swittlich/CcSoM/SoM/SOM.kicad_pcb

## KiCad design SoM/SOM.kicad_pcb (2026-09-17)

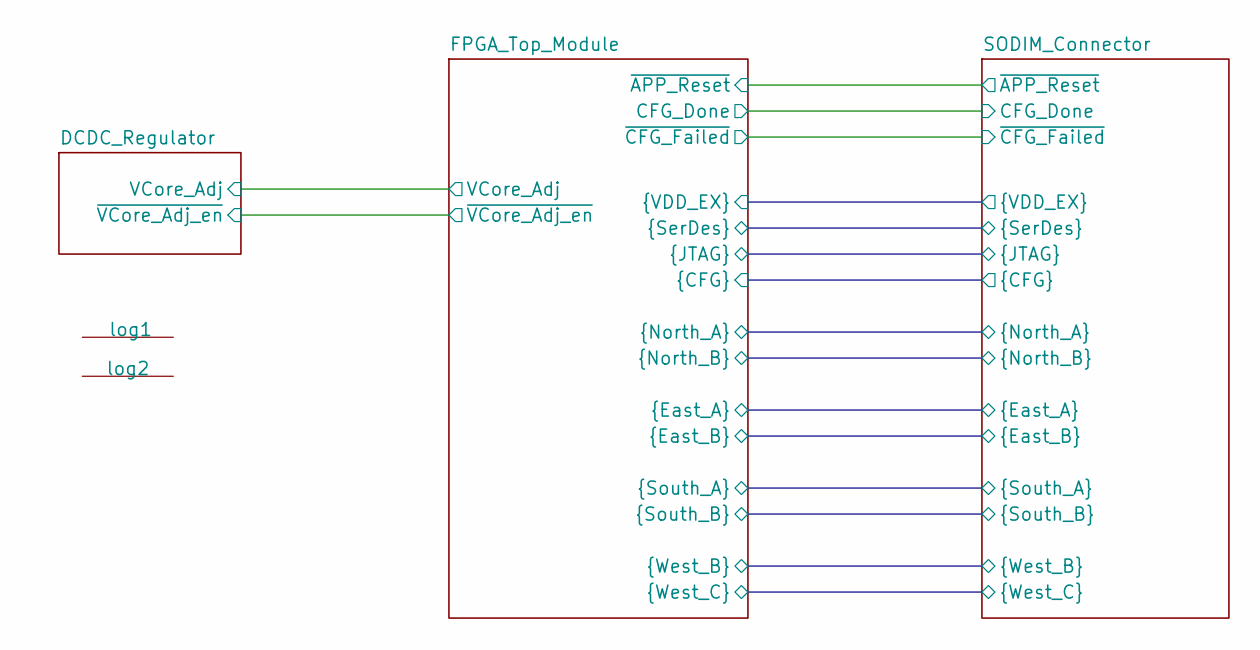
[picture p1: schematic SOM.kicad_sch, CCSoM]

Parts:
log1: PinguinLogo
log2: OpenHardwareLogo

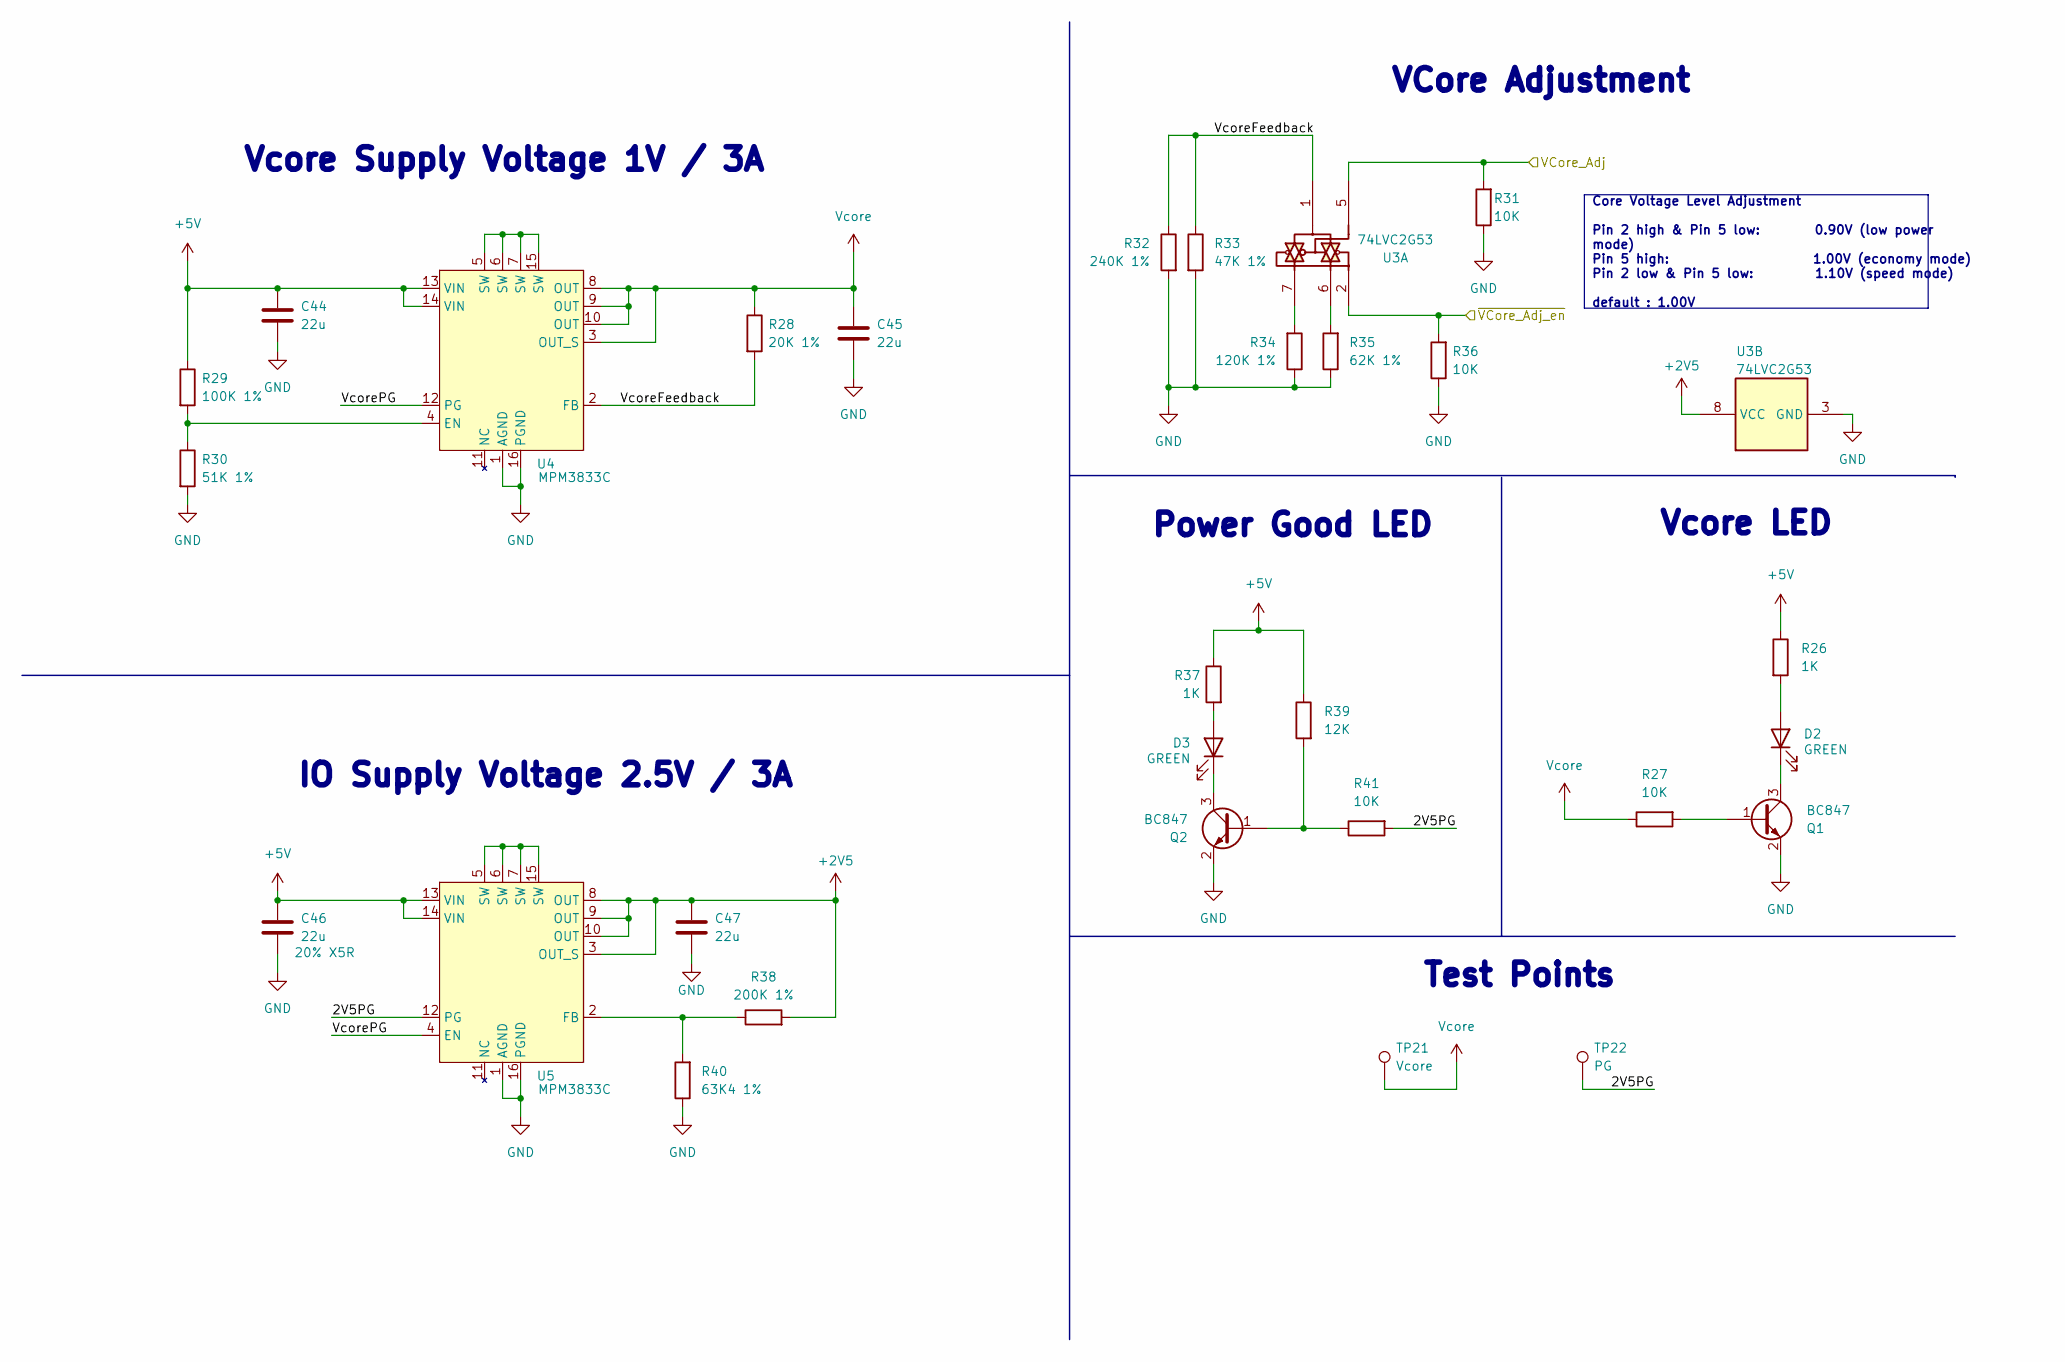
[picture p2: schematic DCDC.kicad_sch, CCSoM]

Parts:
C44, C45, C46, C47: 22u; C_0603_1608Metric; Mouser Part Number GRM188C61C226ME01W
D2, D3: GREEN; LED_0603_1608Metric; Mouser Part Number 150060VS75000
Q1, Q2: BC847; SOT-23; Mouser Part Number BC847C-C
R26, R37: 1K; R_0402_1005Metric; Mouser Part Number MCS04020C1001FE000
R27, R31, R36, R41: 10K; R_0402_1005Metric; Mouser Part Number MCS0402MC1002FE000
R28: 20K 1%; R_0402_1005Metric; Mouser Part Number CRCW040220K0FKED
R29: 100K 1%; R_0402_1005Metric; Mouser Part Number MCS04020C1003FE000
R30: 51K 1%; R_0402_1005Metric; Mouser Part Number CRCW040251K0FKEDC
R32: 240K 1%; R_0402_1005Metric; Mouser Part Number MCS04020C2403FE000
R33: 47K 1%; R_0402_1005Metric; Mouser Part Number CRCW040247K0FKED
R34: 120K 1%; R_0402_1005Metric; Mouser Part Number MCS04020C1203FE000
R35: 62K 1%; R_0402_1005Metric; Mouser Part Number CRCW040262K0FKED
R38: 200K 1%; R_0402_1005Metric; Mouser Part Number CRCW0402200KFKEDC
R39: 12K; R_0402_1005Metric; Mouser Part Number MCS04020C1202FE000
R40: 63K4 1%; R_0402_1005Metric; Mouser Part Number CRCW040263K4FKED
TP21: Vcore; TestPoint_Pad_D1.0mm
TP22: PG; TestPoint_Pad_D1.0mm
U3: 74LVC2G53; DCU8; Mouser Part Number SN74LVC2G53DCUR
U4, U5: MPM3833C; QFN18; Mouser Part Number MPM3833CGRH-Z

Connections:
+2V5: C47.1, R38.2, U3.8 (VCC), U5.3 (OUT_S), U5.8 (OUT), U5.9 (OUT), U5.10 (OUT), U5.20 (OUT); also elsewhere on the board
+5V: C44.1, C46.1, R26.1, R29.1, R37.1, R39.1, U4.13 (VIN), U4.14 (VIN), U5.13 (VIN), U5.14 (VIN); also elsewhere on the board
/DCDC_Regulator/2V5PG: R41.2, TP22.1 (1_1), U5.12 (PG)
/DCDC_Regulator/VcoreFeedback: R28.2, R32.1, R33.1, U3.1, U4.2 (FB)
/DCDC_Regulator/VcorePG: U4.12 (PG), U5.4 (EN)
/FPGA_Top_Module/VcAdj: R31.2, U3.5; also elsewhere on the board
/FPGA_Top_Module/~VcAen: R36.2, U3.2; also elsewhere on the board
GND: C44.2, C45.2, C46.2, C47.2, Q1.2 (E), Q2.2 (E), R30.2, R31.1, R32.2, R33.2, R34.1, R35.1, R36.1, R40.1, U3.3 (GND), U3.4 (GND), U4.1 (AGND), U4.16 (PGND), U5.1 (AGND), U5.16 (PGND); also elsewhere on the board
unnamed: D2.2 (A), R26.2
unnamed: D2.1 (K), Q1.3 (C)
unnamed: D3.2 (A), R37.2
unnamed: D3.1 (K), Q2.3 (C)
unnamed: Q1.1 (B), R27.2
unnamed: Q2.1 (B), R39.2, R41.1
unnamed: R34.2, U3.7
unnamed: R35.2, U3.6
unnamed: R29.2, R30.1, U4.4 (EN)
unnamed: U4.5 (SW), U4.6 (SW), U4.7 (SW), U4.15 (SW), U4.19 (SW)
unnamed: R38.1, R40.2, U5.2 (FB)
unnamed: U5.5 (SW), U5.6 (SW), U5.7 (SW), U5.15 (SW), U5.19 (SW)
Vcore: C45.1, R27.1, R28.1, TP21.1 (1_1), U4.3 (OUT_S), U4.8 (OUT), U4.9 (OUT), U4.10 (OUT), U4.20 (OUT); also elsewhere on the board

Notes on the sheet:
Power Good LED
Test Points
Vcore LED
Vcore Supply Voltage 1V / 3A
IO Supply Voltage 2.5V / 3A
VCore Adjustment
Core Voltage Level Adjustment Pin 2 high & Pin 5 low: 0.90V (low power mode) Pin 5 high: 1.00V (economy mode) Pin 2 low & Pin 5 low: 1.10V (speed mode) default : 1.00V

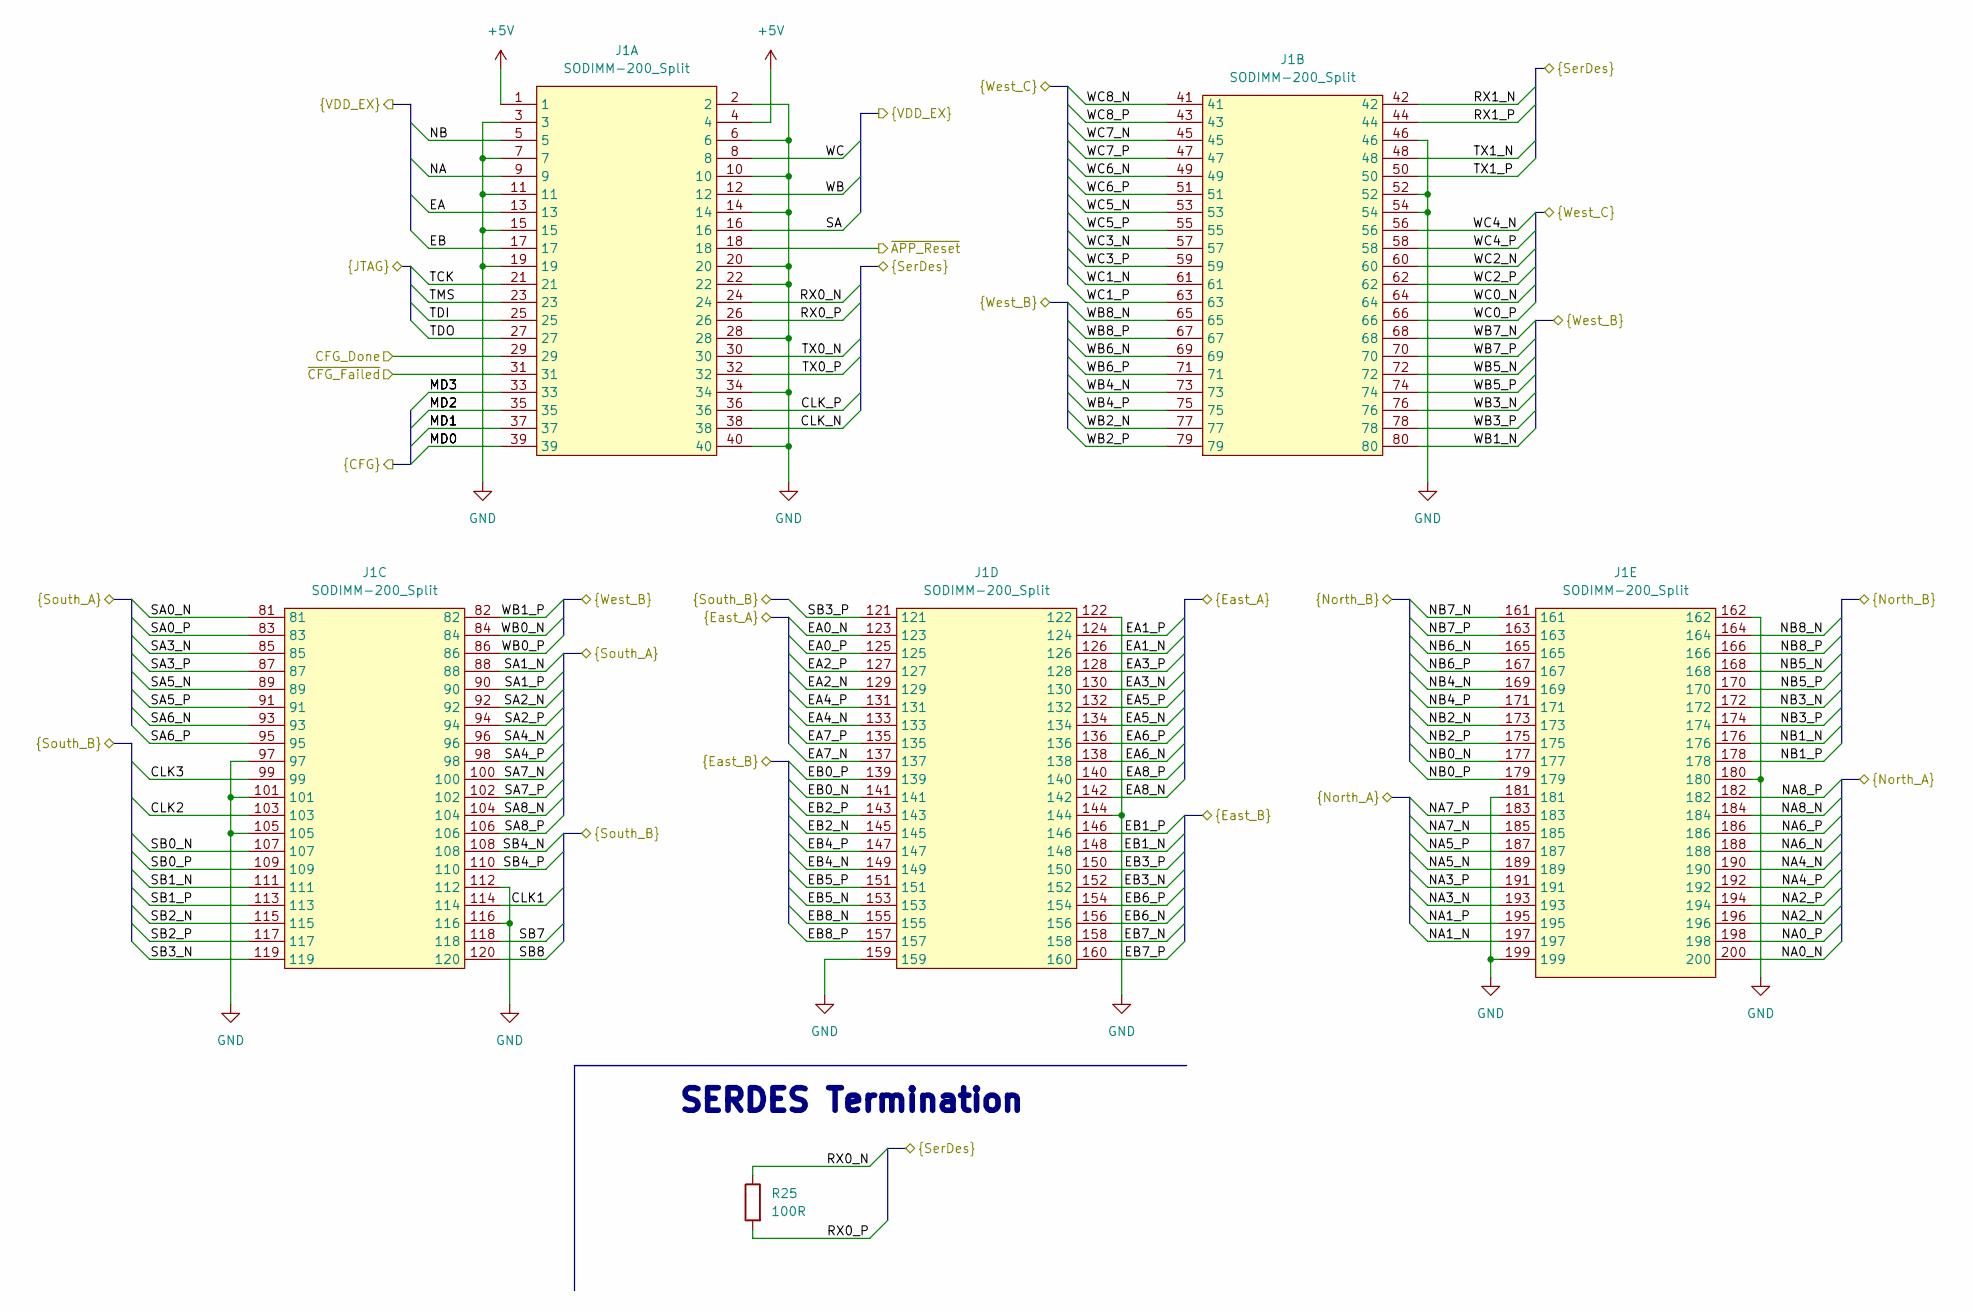
[picture p3: schematic SODIM.kicad_sch, CCSoM]

Parts:
J1: SODIMM-200_Split; SODIMM-200_2.5V_Card_edge
R25: 100R; R_0402_1005Metric; Mouser Part Number MCS04020C1000FE000

Connections:
+5V: J1.1, J1.4; also elsewhere on the board
/FPGA_Top_Module/CFG_Done: J1.29; also elsewhere on the board
/FPGA_Top_Module/CLK1: J1.114; also elsewhere on the board
/FPGA_Top_Module/CLK2: J1.103; also elsewhere on the board
/FPGA_Top_Module/CLK3: J1.99; also elsewhere on the board
/FPGA_Top_Module/CLK_N: J1.38; also elsewhere on the board
/FPGA_Top_Module/CLK_P: J1.36; also elsewhere on the board
/FPGA_Top_Module/EA: J1.13; also elsewhere on the board
/FPGA_Top_Module/EA0_N: J1.123; also elsewhere on the board
/FPGA_Top_Module/EA0_P: J1.125; also elsewhere on the board
/FPGA_Top_Module/EA1_N: J1.126; also elsewhere on the board
/FPGA_Top_Module/EA1_P: J1.124; also elsewhere on the board
/FPGA_Top_Module/EA2_N: J1.129; also elsewhere on the board
/FPGA_Top_Module/EA2_P: J1.127; also elsewhere on the board
/FPGA_Top_Module/EA3_N: J1.130; also elsewhere on the board
/FPGA_Top_Module/EA3_P: J1.128; also elsewhere on the board
/FPGA_Top_Module/EA4_N: J1.133; also elsewhere on the board
/FPGA_Top_Module/EA4_P: J1.131; also elsewhere on the board
/FPGA_Top_Module/EA5_N: J1.134; also elsewhere on the board
/FPGA_Top_Module/EA5_P: J1.132; also elsewhere on the board
/FPGA_Top_Module/EA6_N: J1.138; also elsewhere on the board
/FPGA_Top_Module/EA6_P: J1.136; also elsewhere on the board
/FPGA_Top_Module/EA7_N: J1.137; also elsewhere on the board
/FPGA_Top_Module/EA7_P: J1.135; also elsewhere on the board
/FPGA_Top_Module/EA8_N: J1.142; also elsewhere on the board
/FPGA_Top_Module/EA8_P: J1.140; also elsewhere on the board
/FPGA_Top_Module/EB: J1.17; also elsewhere on the board
/FPGA_Top_Module/EB0_N: J1.141; also elsewhere on the board
/FPGA_Top_Module/EB0_P: J1.139; also elsewhere on the board
/FPGA_Top_Module/EB1_N: J1.148; also elsewhere on the board
/FPGA_Top_Module/EB1_P: J1.146; also elsewhere on the board
/FPGA_Top_Module/EB2_N: J1.145; also elsewhere on the board
/FPGA_Top_Module/EB2_P: J1.143; also elsewhere on the board
/FPGA_Top_Module/EB3_N: J1.152; also elsewhere on the board
/FPGA_Top_Module/EB3_P: J1.150; also elsewhere on the board
/FPGA_Top_Module/EB4_N: J1.149; also elsewhere on the board
/FPGA_Top_Module/EB4_P: J1.147; also elsewhere on the board
/FPGA_Top_Module/EB5_N: J1.153; also elsewhere on the board
/FPGA_Top_Module/EB5_P: J1.151; also elsewhere on the board
/FPGA_Top_Module/EB6_N: J1.156; also elsewhere on the board
/FPGA_Top_Module/EB6_P: J1.154; also elsewhere on the board
/FPGA_Top_Module/EB7_N: J1.158; also elsewhere on the board
/FPGA_Top_Module/EB7_P: J1.160; also elsewhere on the board
/FPGA_Top_Module/EB8_N: J1.155; also elsewhere on the board
/FPGA_Top_Module/EB8_P: J1.157; also elsewhere on the board
/FPGA_Top_Module/MD0: J1.39; also elsewhere on the board
/FPGA_Top_Module/MD1: J1.37; also elsewhere on the board
/FPGA_Top_Module/MD2: J1.35; also elsewhere on the board
/FPGA_Top_Module/MD3: J1.33; also elsewhere on the board
/FPGA_Top_Module/NA: J1.9; also elsewhere on the board
/FPGA_Top_Module/NA0_N: J1.200; also elsewhere on the board
/FPGA_Top_Module/NA0_P: J1.198; also elsewhere on the board
/FPGA_Top_Module/NA1_N: J1.197; also elsewhere on the board
/FPGA_Top_Module/NA1_P: J1.195; also elsewhere on the board
/FPGA_Top_Module/NA2_N: J1.196; also elsewhere on the board
/FPGA_Top_Module/NA2_P: J1.194; also elsewhere on the board
/FPGA_Top_Module/NA3_N: J1.193; also elsewhere on the board
/FPGA_Top_Module/NA3_P: J1.191; also elsewhere on the board
/FPGA_Top_Module/NA4_N: J1.190; also elsewhere on the board
/FPGA_Top_Module/NA4_P: J1.192; also elsewhere on the board
/FPGA_Top_Module/NA5_N: J1.189; also elsewhere on the board
/FPGA_Top_Module/NA5_P: J1.187; also elsewhere on the board
/FPGA_Top_Module/NA6_N: J1.188; also elsewhere on the board
/FPGA_Top_Module/NA6_P: J1.186; also elsewhere on the board
/FPGA_Top_Module/NA7_N: J1.185; also elsewhere on the board
/FPGA_Top_Module/NA7_P: J1.183; also elsewhere on the board
/FPGA_Top_Module/NA8_N: J1.184; also elsewhere on the board
/FPGA_Top_Module/NA8_P: J1.182; also elsewhere on the board
/FPGA_Top_Module/NB: J1.5; also elsewhere on the board
/FPGA_Top_Module/NB0_N: J1.177; also elsewhere on the board
/FPGA_Top_Module/NB0_P: J1.179; also elsewhere on the board
/FPGA_Top_Module/NB1_N: J1.176; also elsewhere on the board
/FPGA_Top_Module/NB1_P: J1.178; also elsewhere on the board
/FPGA_Top_Module/NB2_N: J1.173; also elsewhere on the board
/FPGA_Top_Module/NB2_P: J1.175; also elsewhere on the board
/FPGA_Top_Module/NB3_N: J1.172; also elsewhere on the board
/FPGA_Top_Module/NB3_P: J1.174; also elsewhere on the board
/FPGA_Top_Module/NB4_N: J1.169; also elsewhere on the board
/FPGA_Top_Module/NB4_P: J1.171; also elsewhere on the board
/FPGA_Top_Module/NB5_N: J1.168; also elsewhere on the board
/FPGA_Top_Module/NB5_P: J1.170; also elsewhere on the board
/FPGA_Top_Module/NB6_N: J1.165; also elsewhere on the board
/FPGA_Top_Module/NB6_P: J1.167; also elsewhere on the board
/FPGA_Top_Module/NB7_N: J1.161; also elsewhere on the board
/FPGA_Top_Module/NB7_P: J1.163; also elsewhere on the board
/FPGA_Top_Module/NB8_N: J1.164; also elsewhere on the board
/FPGA_Top_Module/NB8_P: J1.166; also elsewhere on the board
/FPGA_Top_Module/RX0_N: J1.24, R25.1; also elsewhere on the board
/FPGA_Top_Module/RX0_P: J1.26, R25.2; also elsewhere on the board
/FPGA_Top_Module/RX1_N: J1.42; also elsewhere on the board
/FPGA_Top_Module/RX1_P: J1.44; also elsewhere on the board
/FPGA_Top_Module/SA: J1.16; also elsewhere on the board
/FPGA_Top_Module/SA0_N: J1.81; also elsewhere on the board
/FPGA_Top_Module/SA0_P: J1.83; also elsewhere on the board
/FPGA_Top_Module/SA1_N: J1.88; also elsewhere on the board
/FPGA_Top_Module/SA1_P: J1.90; also elsewhere on the board
/FPGA_Top_Module/SA2_N: J1.92; also elsewhere on the board
/FPGA_Top_Module/SA2_P: J1.94; also elsewhere on the board
/FPGA_Top_Module/SA3_N: J1.85; also elsewhere on the board
/FPGA_Top_Module/SA3_P: J1.87; also elsewhere on the board
/FPGA_Top_Module/SA4_N: J1.96; also elsewhere on the board
/FPGA_Top_Module/SA4_P: J1.98; also elsewhere on the board
/FPGA_Top_Module/SA5_N: J1.89; also elsewhere on the board
/FPGA_Top_Module/SA5_P: J1.91; also elsewhere on the board
/FPGA_Top_Module/SA6_N: J1.93; also elsewhere on the board
/FPGA_Top_Module/SA6_P: J1.95; also elsewhere on the board
/FPGA_Top_Module/SA7_N: J1.100; also elsewhere on the board
/FPGA_Top_Module/SA7_P: J1.102; also elsewhere on the board
/FPGA_Top_Module/SA8_N: J1.104; also elsewhere on the board
/FPGA_Top_Module/SA8_P: J1.106; also elsewhere on the board
/FPGA_Top_Module/SB0_N: J1.107; also elsewhere on the board
/FPGA_Top_Module/SB0_P: J1.109; also elsewhere on the board
/FPGA_Top_Module/SB1_N: J1.111; also elsewhere on the board
/FPGA_Top_Module/SB1_P: J1.113; also elsewhere on the board
/FPGA_Top_Module/SB2_N: J1.115; also elsewhere on the board
/FPGA_Top_Module/SB2_P: J1.117; also elsewhere on the board
/FPGA_Top_Module/SB3_N: J1.119; also elsewhere on the board
/FPGA_Top_Module/SB3_P: J1.121; also elsewhere on the board
/FPGA_Top_Module/SB4_N: J1.108; also elsewhere on the board
/FPGA_Top_Module/SB4_P: J1.110; also elsewhere on the board
/FPGA_Top_Module/SB7: J1.118; also elsewhere on the board
/FPGA_Top_Module/SB8: J1.120; also elsewhere on the board
/FPGA_Top_Module/TCK: J1.21; also elsewhere on the board
/FPGA_Top_Module/TDI: J1.25; also elsewhere on the board
/FPGA_Top_Module/TDO: J1.27; also elsewhere on the board
/FPGA_Top_Module/TMS: J1.23; also elsewhere on the board
/FPGA_Top_Module/TX0_N: J1.30; also elsewhere on the board
/FPGA_Top_Module/TX0_P: J1.32; also elsewhere on the board
/FPGA_Top_Module/TX1_N: J1.48; also elsewhere on the board
/FPGA_Top_Module/TX1_P: J1.50; also elsewhere on the board
/FPGA_Top_Module/WB: J1.12; also elsewhere on the board
/FPGA_Top_Module/WB0_N: J1.84; also elsewhere on the board
/FPGA_Top_Module/WB0_P: J1.86; also elsewhere on the board
/FPGA_Top_Module/WB1_N: J1.80; also elsewhere on the board
/FPGA_Top_Module/WB1_P: J1.82; also elsewhere on the board
/FPGA_Top_Module/WB2_N: J1.77; also elsewhere on the board
/FPGA_Top_Module/WB2_P: J1.79; also elsewhere on the board
/FPGA_Top_Module/WB3_N: J1.76; also elsewhere on the board
/FPGA_Top_Module/WB3_P: J1.78; also elsewhere on the board
/FPGA_Top_Module/WB4_N: J1.73; also elsewhere on the board
/FPGA_Top_Module/WB4_P: J1.75; also elsewhere on the board
/FPGA_Top_Module/WB5_N: J1.72; also elsewhere on the board
/FPGA_Top_Module/WB5_P: J1.74; also elsewhere on the board
/FPGA_Top_Module/WB6_N: J1.69; also elsewhere on the board
/FPGA_Top_Module/WB6_P: J1.71; also elsewhere on the board
/FPGA_Top_Module/WB7_N: J1.68; also elsewhere on the board
/FPGA_Top_Module/WB7_P: J1.70; also elsewhere on the board
/FPGA_Top_Module/WB8_N: J1.65; also elsewhere on the board
/FPGA_Top_Module/WB8_P: J1.67; also elsewhere on the board
/FPGA_Top_Module/WC: J1.8; also elsewhere on the board
/FPGA_Top_Module/WC0_N: J1.64; also elsewhere on the board
/FPGA_Top_Module/WC0_P: J1.66; also elsewhere on the board
/FPGA_Top_Module/WC1_N: J1.61; also elsewhere on the board
/FPGA_Top_Module/WC1_P: J1.63; also elsewhere on the board
/FPGA_Top_Module/WC2_N: J1.60; also elsewhere on the board
/FPGA_Top_Module/WC2_P: J1.62; also elsewhere on the board
/FPGA_Top_Module/WC3_N: J1.57; also elsewhere on the board
/FPGA_Top_Module/WC3_P: J1.59; also elsewhere on the board
/FPGA_Top_Module/WC4_N: J1.56; also elsewhere on the board
/FPGA_Top_Module/WC4_P: J1.58; also elsewhere on the board
/FPGA_Top_Module/WC5_N: J1.53; also elsewhere on the board
/FPGA_Top_Module/WC5_P: J1.55; also elsewhere on the board
/FPGA_Top_Module/WC6_N: J1.49; also elsewhere on the board
/FPGA_Top_Module/WC6_P: J1.51; also elsewhere on the board
/FPGA_Top_Module/WC7_N: J1.45; also elsewhere on the board
/FPGA_Top_Module/WC7_P: J1.47; also elsewhere on the board
/FPGA_Top_Module/WC8_N: J1.41; also elsewhere on the board
/FPGA_Top_Module/WC8_P: J1.43; also elsewhere on the board
/FPGA_Top_Module/~CFG_Failed: J1.31; also elsewhere on the board
/FPGA_Top_Module/~Rst: J1.18; also elsewhere on the board
GND: J1.2, J1.3, J1.6, J1.7, J1.10, J1.11, J1.14, J1.15, J1.19, J1.20, J1.22, J1.28, J1.34, J1.40, J1.46, J1.52, J1.54, J1.97, J1.101, J1.105, J1.112, J1.116, J1.122, J1.144, J1.159, J1.162, J1.180, J1.181, J1.199; also elsewhere on the board

Notes on the sheet:
SERDES Termination

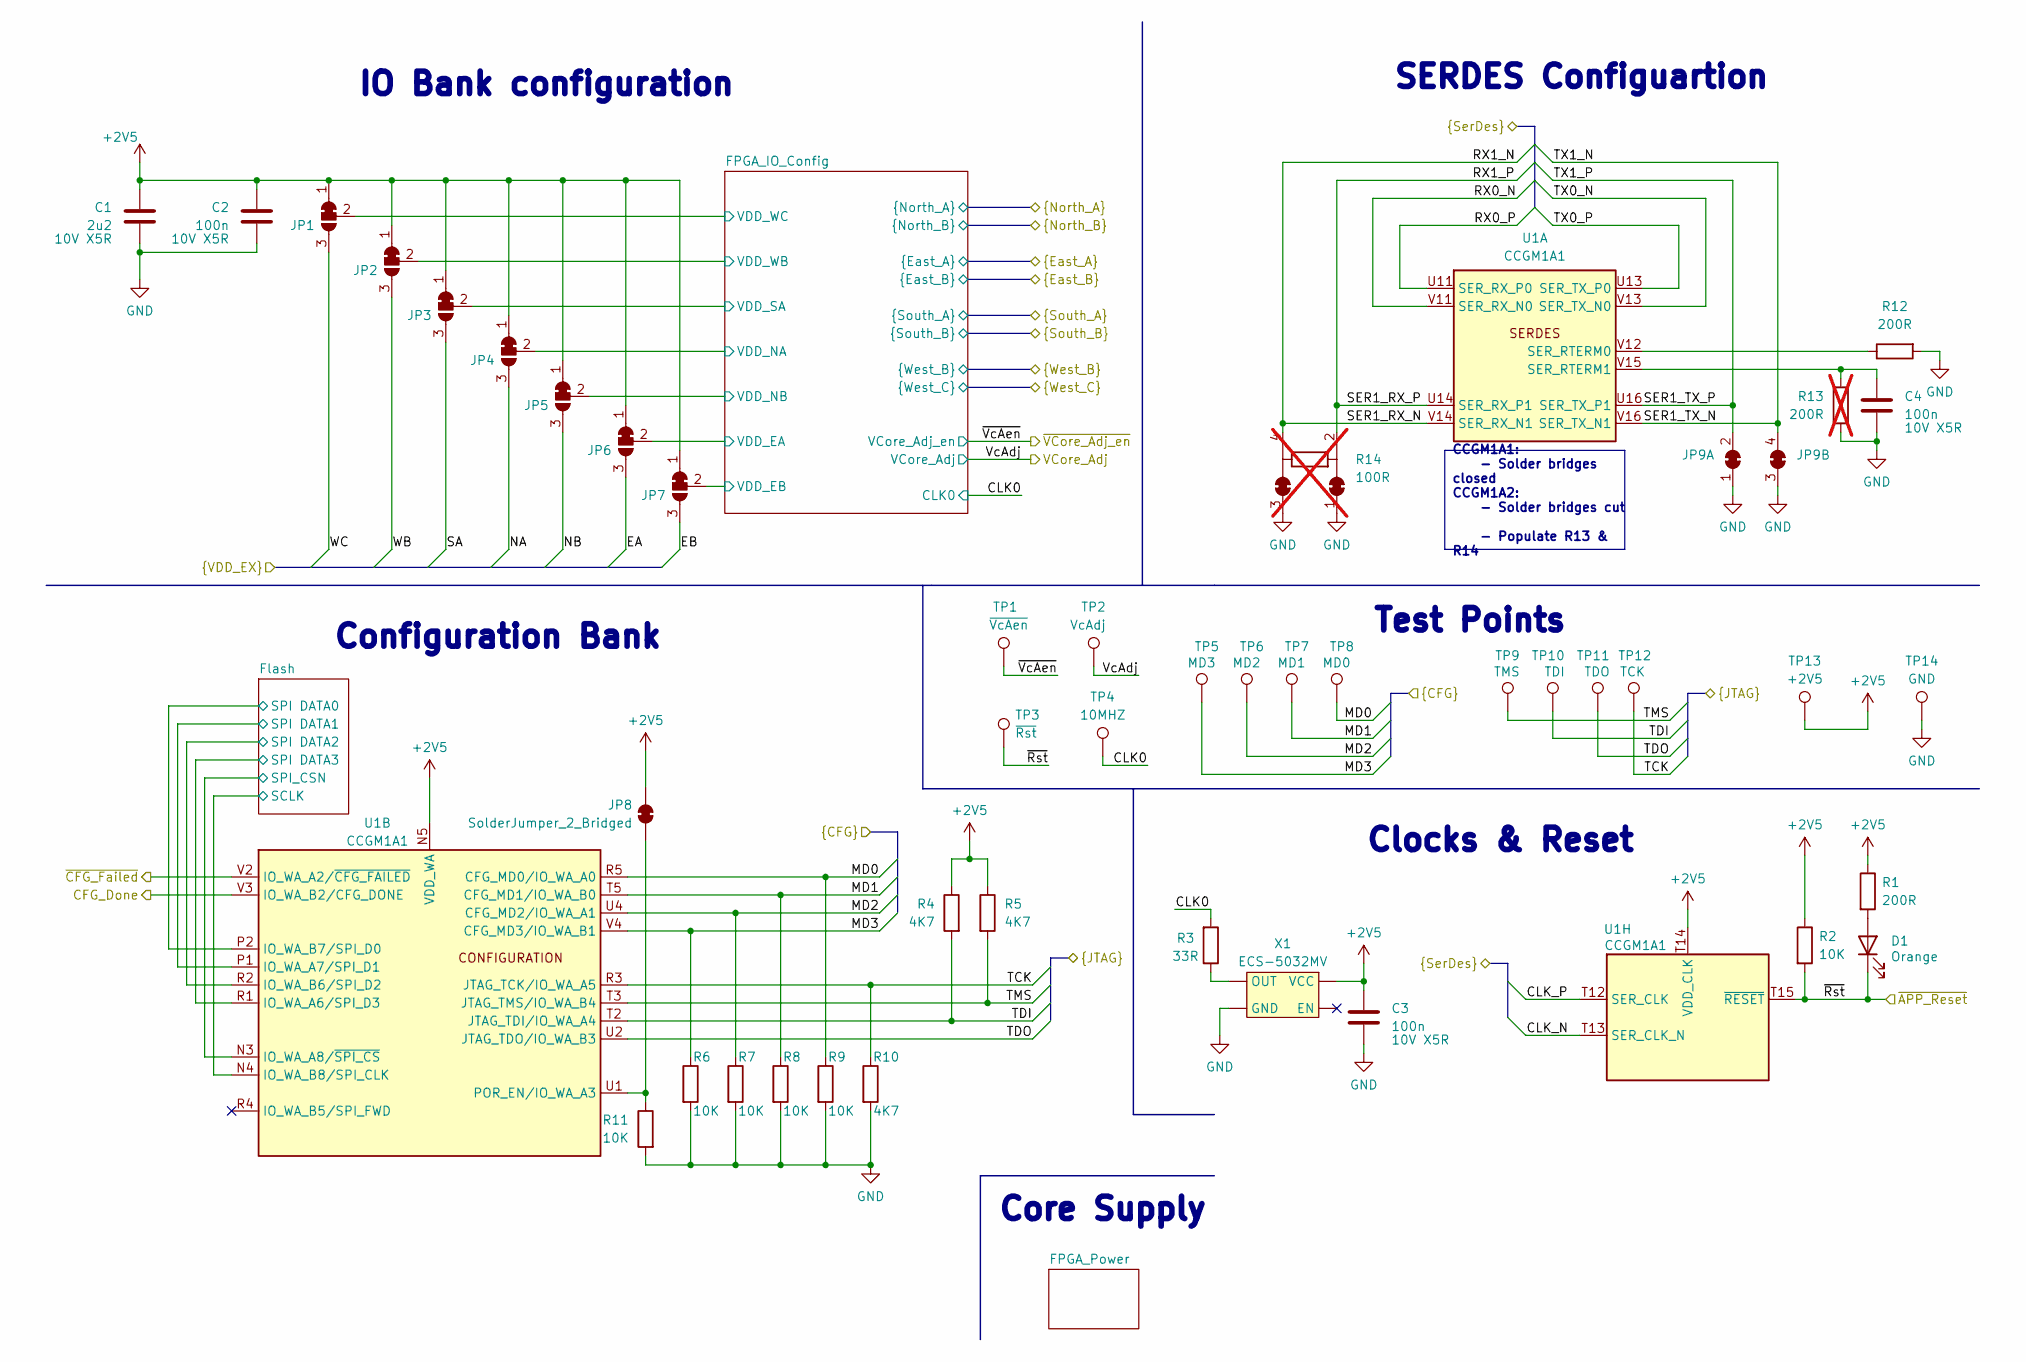
[picture p4: schematic FPGA_TOP.kicad_sch, CCSoM]

Parts:
C1: 2u2; C_0402_1005Metric; Voltage/Precision 10V X5R; Mouser Part Number GRM155Z71A225KE44D
C2, C3, C4: 100n; C_0402_1005Metric; Voltage/Precision 10V X5R; Mouser Part Number GRM155R71C104KA88J
D1: Orange; LED_0603_1608Metric; Mouser Part Number APT1608SECK-AMT
JP1, JP2, JP3, JP4, JP5, JP6, JP7: SolderJumper_3_Bridged12; SolderBridge3Pin
JP8: SolderJumper_2_Bridged; Solderbridge_closed
JP9: Diff_pair_solderbridge_closed
R1, R12: 200R; R_0402_1005Metric; Mouser Part Number MCS04020C2000FE000
R2, R6, R7, R8, R9, R11: 10K; R_0402_1005Metric; Mouser Part Number MCS0402MC1002FE000
R3: 33R; R_0402_1005Metric; Mouser Part Number MCS04020C3309FE000
R4, R5, R10: 4K7; R_0402_1005Metric; Mouser Part Number CRCW04024K70FKED
R13: 200R; R_0402_1005Metric; Mouser Part Number 71-CRCW0201-200; not fitted
R14: 100R; Diff_pair_solderbridge_closed; not fitted
TP1: ~{VcAen}; TestPoint_Pad_D1.0mm
TP2: VcAdj; TestPoint_Pad_D1.0mm
TP3: ~{Rst}; TestPoint_Pad_D1.0mm
TP4: 10MHZ; TestPoint_Pad_D1.0mm
TP5: MD3; TestPoint_Pad_D1.0mm
TP6: MD2; TestPoint_Pad_D1.0mm
TP7: MD1; TestPoint_Pad_D1.0mm
TP8: MD0; TestPoint_Pad_D1.0mm
TP9: TMS; TestPoint_Pad_D1.0mm
TP10: TDI; TestPoint_Pad_D1.0mm
TP11: TDO; TestPoint_Pad_D1.0mm
TP12: TCK; TestPoint_Pad_D1.0mm
TP13: +2V5; TestPoint_Pad_D1.0mm
TP14: GND; TestPoint_Pad_D1.0mm
U1: CCGM1A1; BGA-324_15x15mm_Layout18x18_P0.8mm; Mouser Part Number CCGM1A1-BGA324
X1: ECS-5032MV; 5x3.2_Oscillator; Mouser Part Number ECS-5032MV-100-BN-TR

Connections:
+2V5: C1.1, C2.1, C3.1, JP1.1 (A), JP2.1 (A), JP3.1 (A), JP4.1 (A), JP5.1 (A), JP6.1 (A), JP7.1 (A), JP8.2 (B), R1.1, R2.1, R4.1, R5.1, TP13.1 (1_1), U1.N5 (VDD_WA), U1.P3 (VDD_WA), U1.P5 (VDD_WA), U1.T1 (VDD_WA), U1.T14 (VDD_CLK), U1.U3 (VDD_WA), X1.4 (VCC); also elsewhere on the board
/FPGA_Top_Module/CFG_Done: U1.V3 (IO_WA_B2/CFG_DONE); also elsewhere on the board
/FPGA_Top_Module/CLK0: R3.2, TP4.1 (1_1); also elsewhere on the board
/FPGA_Top_Module/CLK_N: U1.T13 (SER_CLK_N); also elsewhere on the board
/FPGA_Top_Module/CLK_P: U1.T12 (SER_CLK); also elsewhere on the board
/FPGA_Top_Module/EA: JP6.3 (B); also elsewhere on the board
/FPGA_Top_Module/EB: JP7.3 (B); also elsewhere on the board
/FPGA_Top_Module/FPGA_IO_Config/VDD_EA: JP6.2 (C); also elsewhere on the board
/FPGA_Top_Module/FPGA_IO_Config/VDD_EB: JP7.2 (C); also elsewhere on the board
/FPGA_Top_Module/FPGA_IO_Config/VDD_NA: JP4.2 (C); also elsewhere on the board
/FPGA_Top_Module/FPGA_IO_Config/VDD_NB: JP5.2 (C); also elsewhere on the board
/FPGA_Top_Module/FPGA_IO_Config/VDD_SA: JP3.2 (C); also elsewhere on the board
/FPGA_Top_Module/FPGA_IO_Config/VDD_WB: JP2.2 (C); also elsewhere on the board
/FPGA_Top_Module/FPGA_IO_Config/VDD_WC: JP1.2 (C); also elsewhere on the board
/FPGA_Top_Module/Flash/SCLK: U1.N4 (IO_WA_B8/SPI_CLK); also elsewhere on the board
/FPGA_Top_Module/Flash/SPI DATA0: U1.P2 (IO_WA_B7/SPI_D0); also elsewhere on the board
/FPGA_Top_Module/Flash/SPI DATA1: U1.P1 (IO_WA_A7/SPI_D1); also elsewhere on the board
/FPGA_Top_Module/Flash/SPI DATA2: U1.R2 (IO_WA_B6/SPI_D2); also elsewhere on the board
/FPGA_Top_Module/Flash/SPI DATA3: U1.R1 (IO_WA_A6/SPI_D3); also elsewhere on the board
/FPGA_Top_Module/Flash/SPI_CSN: U1.N3 (IO_WA_A8/~SPI_CS); also elsewhere on the board
/FPGA_Top_Module/MD0: R9.1, TP8.1 (1_1), U1.R5 (CFG_MD0/IO_WA_A0); also elsewhere on the board
/FPGA_Top_Module/MD1: R8.1, TP7.1 (1_1), U1.T5 (CFG_MD1/IO_WA_B0); also elsewhere on the board
/FPGA_Top_Module/MD2: R7.1, TP6.1 (1_1), U1.U4 (CFG_MD2/IO_WA_A1); also elsewhere on the board
/FPGA_Top_Module/MD3: R6.1, TP5.1 (1_1), U1.V4 (CFG_MD3/IO_WA_B1); also elsewhere on the board
/FPGA_Top_Module/NA: JP4.3 (B); also elsewhere on the board
/FPGA_Top_Module/NB: JP5.3 (B); also elsewhere on the board
/FPGA_Top_Module/RX0_N: U1.V11 (SER_RX_N0); also elsewhere on the board
/FPGA_Top_Module/RX0_P: U1.U11 (SER_RX_P0); also elsewhere on the board
/FPGA_Top_Module/RX1_N: R14.4, U1.V14 (SER_RX_N1); also elsewhere on the board
/FPGA_Top_Module/RX1_P: R14.2, U1.U14 (SER_RX_P1); also elsewhere on the board
/FPGA_Top_Module/SA: JP3.3 (B); also elsewhere on the board
/FPGA_Top_Module/TCK: R10.1, TP12.1 (1_1), U1.R3 (JTAG_TCK/IO_WA_A5); also elsewhere on the board
/FPGA_Top_Module/TDI: R4.2, TP10.1 (1_1), U1.T2 (JTAG_TDI/IO_WA_A4); also elsewhere on the board
/FPGA_Top_Module/TDO: TP11.1 (1_1), U1.U2 (JTAG_TDO/IO_WA_B3); also elsewhere on the board
/FPGA_Top_Module/TMS: R5.2, TP9.1 (1_1), U1.T3 (JTAG_TMS/IO_WA_B4); also elsewhere on the board
/FPGA_Top_Module/TX0_N: U1.V13 (SER_TX_N0); also elsewhere on the board
/FPGA_Top_Module/TX0_P: U1.U13 (SER_TX_P0); also elsewhere on the board
/FPGA_Top_Module/TX1_N: JP9.4 (B), U1.V16 (SER_TX_N1); also elsewhere on the board
/FPGA_Top_Module/TX1_P: JP9.2 (B), U1.U16 (SER_TX_P1); also elsewhere on the board
/FPGA_Top_Module/VcAdj: TP2.1 (1_1); also elsewhere on the board
/FPGA_Top_Module/WB: JP2.3 (B); also elsewhere on the board
/FPGA_Top_Module/WC: JP1.3 (B); also elsewhere on the board
/FPGA_Top_Module/~CFG_Failed: U1.V2 (IO_WA_A2/~CFG_FAILED); also elsewhere on the board
/FPGA_Top_Module/~Rst: D1.1 (K), R2.2, TP3.1 (1_1), U1.T15 (~RESET); also elsewhere on the board
/FPGA_Top_Module/~VcAen: TP1.1 (1_1); also elsewhere on the board
GND: C1.2, C2.2, C3.2, C4.2, JP9.1 (A), JP9.3 (A), R6.2, R7.2, R8.2, R9.2, R10.2, R11.2, R12.2, R13.2, R14.1 (A), R14.3 (A), TP14.1 (1_1), X1.2 (GND); also elsewhere on the board
unnamed: D1.2 (A), R1.2
unnamed: JP8.1 (A), R11.1, U1.U1 (POR_EN/IO_WA_A3)
unnamed: R12.1, U1.V12 (SER_RTERM0)
unnamed: C4.1, R13.1, U1.V15 (SER_RTERM1)
unnamed: R3.1, X1.3 (OUT)

Notes on the sheet:
Test Points
IO Bank configuration
Core Supply
Clocks & Reset
SERDES Configuartion
Configuration Bank
CCGM1A1: - Solder bridges closed CCGM1A2: - Solder bridges cut - Populate R13 & R14

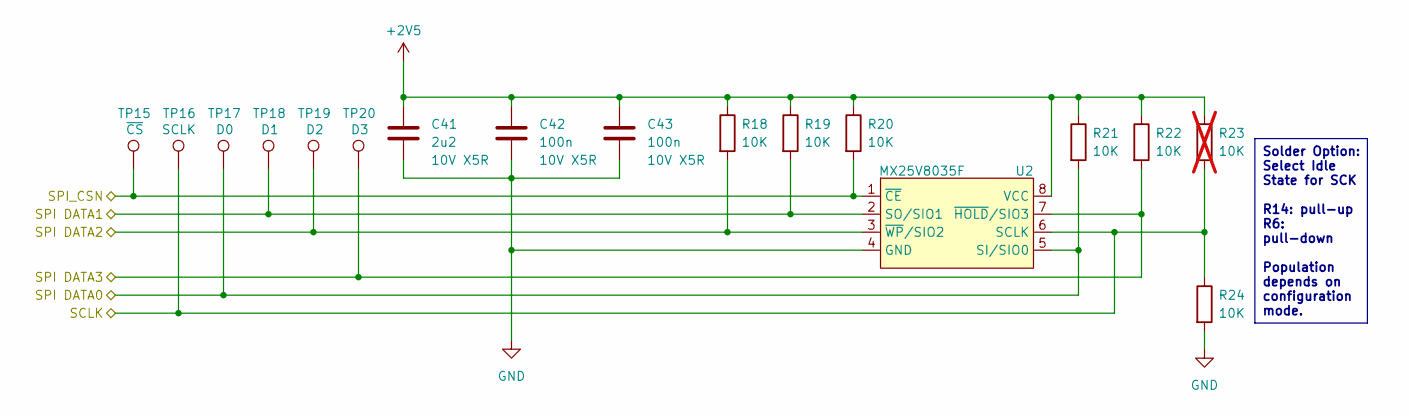
[picture p5: schematic Flash.kicad_sch, CCSoM]

Parts:
C41: 2u2; C_0402_1005Metric; Voltage/Precision 10V X5R; Mouser Part Number GRM155Z71A225KE44D
C42, C43: 100n; C_0402_1005Metric; Voltage/Precision 10V X5R; Mouser Part Number GRM155R71C104KA88J
R18, R19, R20, R21, R22, R24: 10K; R_0402_1005Metric; Mouser Part Number MCS0402MC1002FE000
R23: 10K; R_0402_1005Metric; Mouser Part Number 71-CRCW0201-10K; not fitted
TP15: ~{CS}; TestPoint_Pad_D1.0mm
TP16: SCLK; TestPoint_Pad_D1.0mm
TP17: D0; TestPoint_Pad_D1.0mm
TP18: D1; TestPoint_Pad_D1.0mm
TP19: D2; TestPoint_Pad_D1.0mm
TP20: D3; TestPoint_Pad_D1.0mm
U2: MX25V8035F; SOP-8(150_200MIL); Mouser Part Number MX25V8035FM2I

Connections:
+2V5: C41.1, C42.1, C43.1, R18.1, R19.1, R20.1, R21.1, R22.1, R23.1, U2.8 (VCC); also elsewhere on the board
/FPGA_Top_Module/Flash/SCLK: R23.2, R24.1, TP16.1 (1_1), U2.6 (SCLK); also elsewhere on the board
/FPGA_Top_Module/Flash/SPI DATA0: R21.2, TP17.1 (1_1), U2.5 (SI/SIO0); also elsewhere on the board
/FPGA_Top_Module/Flash/SPI DATA1: R19.2, TP18.1 (1_1), U2.2 (SO/SIO1); also elsewhere on the board
/FPGA_Top_Module/Flash/SPI DATA2: R18.2, TP19.1 (1_1), U2.3 (~WP/SIO2); also elsewhere on the board
/FPGA_Top_Module/Flash/SPI DATA3: R22.2, TP20.1 (1_1), U2.7 (~HOLD/SIO3); also elsewhere on the board
/FPGA_Top_Module/Flash/SPI_CSN: R20.2, TP15.1 (1_1), U2.1 (~CE); also elsewhere on the board
GND: C41.2, C42.2, C43.2, R24.2, U2.4 (GND); also elsewhere on the board

Notes on the sheet:
Solder Option: Select Idle State for SCK R14: pull-up R6: pull-down Population depends on configuration mode.
