swittlich/CcSoM/SoM/SOM.kicad_pcb

## KiCad design SoM/SOM.kicad_pcb (continued)

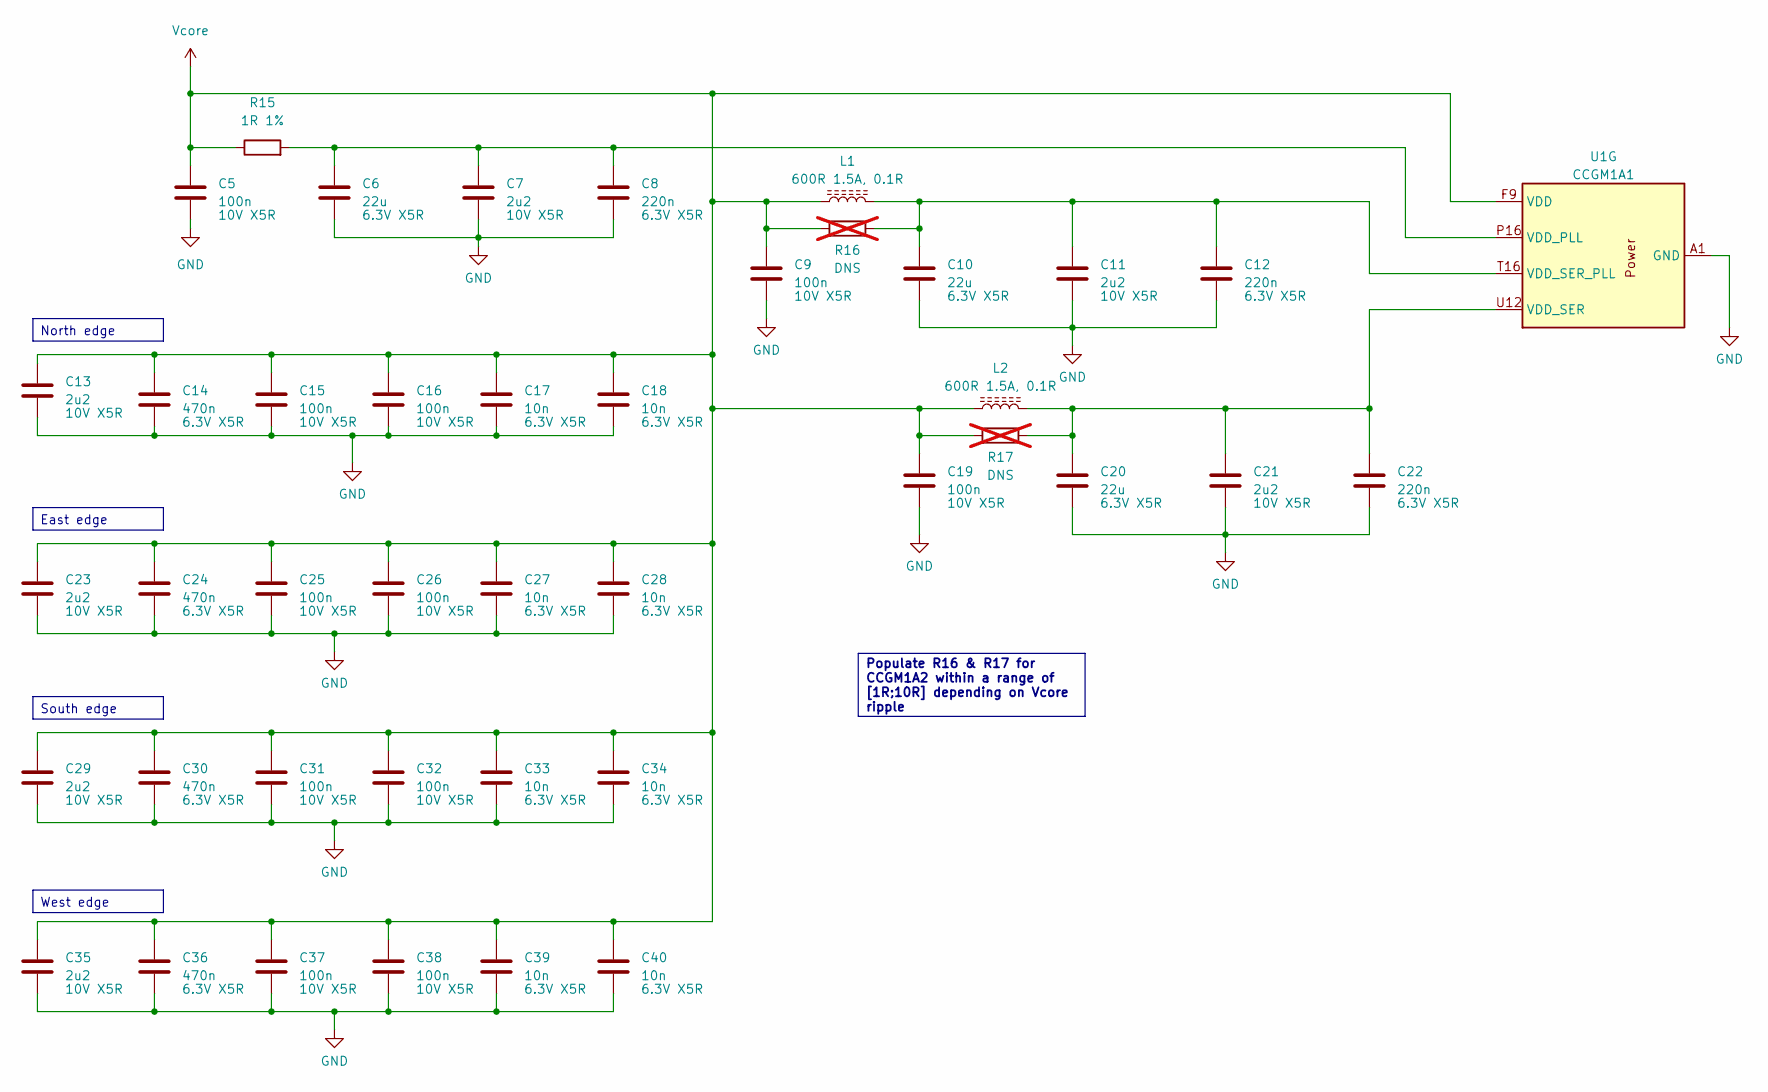
[picture p6: schematic FPGA_Power.kicad_sch, CCSoM]

Parts:
C5, C9, C15, C16, C19, C25, C26, C31, C32, C37, C38: 100n; C_0402_1005Metric; Voltage/Precision 10V X5R; Mouser Part Number GRM155R71C104KA88J
C6, C10, C20: 22u; C_0603_1608Metric; Voltage/Precision 6.3V X5R; Mouser Part Number GRM188C61C226ME01W
C7, C11, C13, C21, C23, C29, C35: 2u2; C_0402_1005Metric; Voltage/Precision 10V X5R; Mouser Part Number GRM155Z71A225KE44D
C8, C12, C22: 220n; C_0402_1005Metric; Voltage/Precision 6.3V X5R; Mouser Part Number GRM155R71C224KA12D
C14, C24, C30, C36: 470n; C_0402_1005Metric; Voltage/Precision 6.3V X5R; Mouser Part Number GRT155C81C474KE01D
C17, C18, C27, C28, C33, C34, C39, C40: 10n; C_0402_1005Metric; Voltage/Precision 6.3V X5R; Mouser Part Number GRM155R71C103KA01D
L1, L2: 600R 1.5A, 0.1R; C_0603_1608Metric; Mouser Part Number 74269262601
R15: 1R 1%; R_0402_1005Metric; Mouser Part Number CRCW04021R00FKEDHP
R16, R17: DNS; R_0402_1005Metric; Mouser Part Number 71-CRCW020133R0FNED; not fitted
U1: CCGM1A1; BGA-324_15x15mm_Layout18x18_P0.8mm; Mouser Part Number CCGM1A1-BGA324

Connections:
GND: C5.2, C6.2, C7.2, C8.2, C9.2, C10.2, C11.2, C12.2, C13.2, C14.2, C15.2, C16.2, C17.2, C18.2, C19.2, C20.2, C21.2, C22.2, C23.2, C24.2, C25.2, C26.2, C27.2, C28.2, C29.2, C30.2, C31.2, C32.2, C33.2, C34.2, C35.2, C36.2, C37.2, C38.2, C39.2, C40.2, U1.A1 (GND), U1.A7 (GND), U1.A10 (GND), U1.A13 (GND), U1.A18 (GND), U1.B16 (GND), U1.C1 (GND), U1.E5 (GND), U1.E7 (GND), U1.E9 (GND), U1.E11 (GND), U1.E13 (GND), U1.E18 (GND), U1.F1 (GND), U1.F6 (GND), U1.F8 (GND), U1.F10 (GND), U1.F12 (GND), U1.F14 (GND), U1.G5 (GND), U1.G7 (GND), U1.G9 (GND), U1.G11 (GND), U1.G13 (GND), U1.H6 (GND), U1.H8 (GND), U1.H10 (GND), U1.H12 (GND), U1.H14 (GND), U1.H18 (GND), U1.J1 (GND), U1.J5 (GND), U1.J7 (GND), U1.J9 (GND), U1.J11 (GND), U1.J13 (GND), U1.K6 (GND), U1.K8 (GND), U1.K10 (GND), U1.K12 (GND), U1.K14 (GND), U1.L5 (GND), U1.L7 (GND), U1.L9 (GND), U1.L11 (GND), U1.L13 (GND), U1.L18 (GND), U1.M1 (GND), U1.M6 (GND), U1.M8 (GND), U1.M10 (GND), U1.M12 (GND), U1.M16 (GND), U1.N7 (GND), U1.N9 (GND), U1.N12 (GND), U1.N17 (GND), U1.P4 (GND), U1.P7 (GND), U1.P9 (GND), U1.R12 (GND), U1.R16 (GND), U1.T4 (GND), U1.T11 (GND), U1.T17 (GND), U1.U15 (GND), U1.V1 (GND), U1.V6 (GND), U1.V9 (GND), U1.V18 (GND); also elsewhere on the board
unnamed: C20.1, C21.1, C22.1, L2.2, R17.1, U1.U12 (VDD_SER), U1.V17 (VDD_SER)
unnamed: C6.1, C7.1, C8.1, R15.2, U1.P16 (VDD_PLL)
unnamed: C10.1, C11.1, C12.1, L1.2, R16.1, U1.T16 (VDD_SER_PLL)
Vcore: C5.1, C9.1, C13.1, C14.1, C15.1, C16.1, C17.1, C18.1, C19.1, C23.1, C24.1, C25.1, C26.1, C27.1, C28.1, C29.1, C30.1, C31.1, C32.1, C33.1, C34.1, C35.1, C36.1, C37.1, C38.1, C39.1, C40.1, L1.1, L2.1, R15.1, R16.2, R17.2, U1.F9 (VDD), U1.G6 (VDD), U1.G8 (VDD), U1.G10 (VDD), U1.G12 (VDD), U1.H7 (VDD), U1.H9 (VDD), U1.H11 (VDD), U1.H13 (VDD), U1.J6 (VDD), U1.J8 (VDD), U1.J10 (VDD), U1.J12 (VDD), U1.K7 (VDD), U1.K9 (VDD), U1.K11 (VDD), U1.K13 (VDD), U1.L6 (VDD), U1.L8 (VDD), U1.L10 (VDD), U1.L12 (VDD), U1.M7 (VDD), U1.M9 (VDD), U1.M11 (VDD), U1.M13 (VDD), U1.N6 (VDD), U1.N8 (VDD), U1.N10 (VDD); also elsewhere on the board

Notes on the sheet:
East edge
North edge
South edge
Populate R16 & R17 for CCGM1A2 within a range of [1R;10R] depending on Vcore ripple
West edge

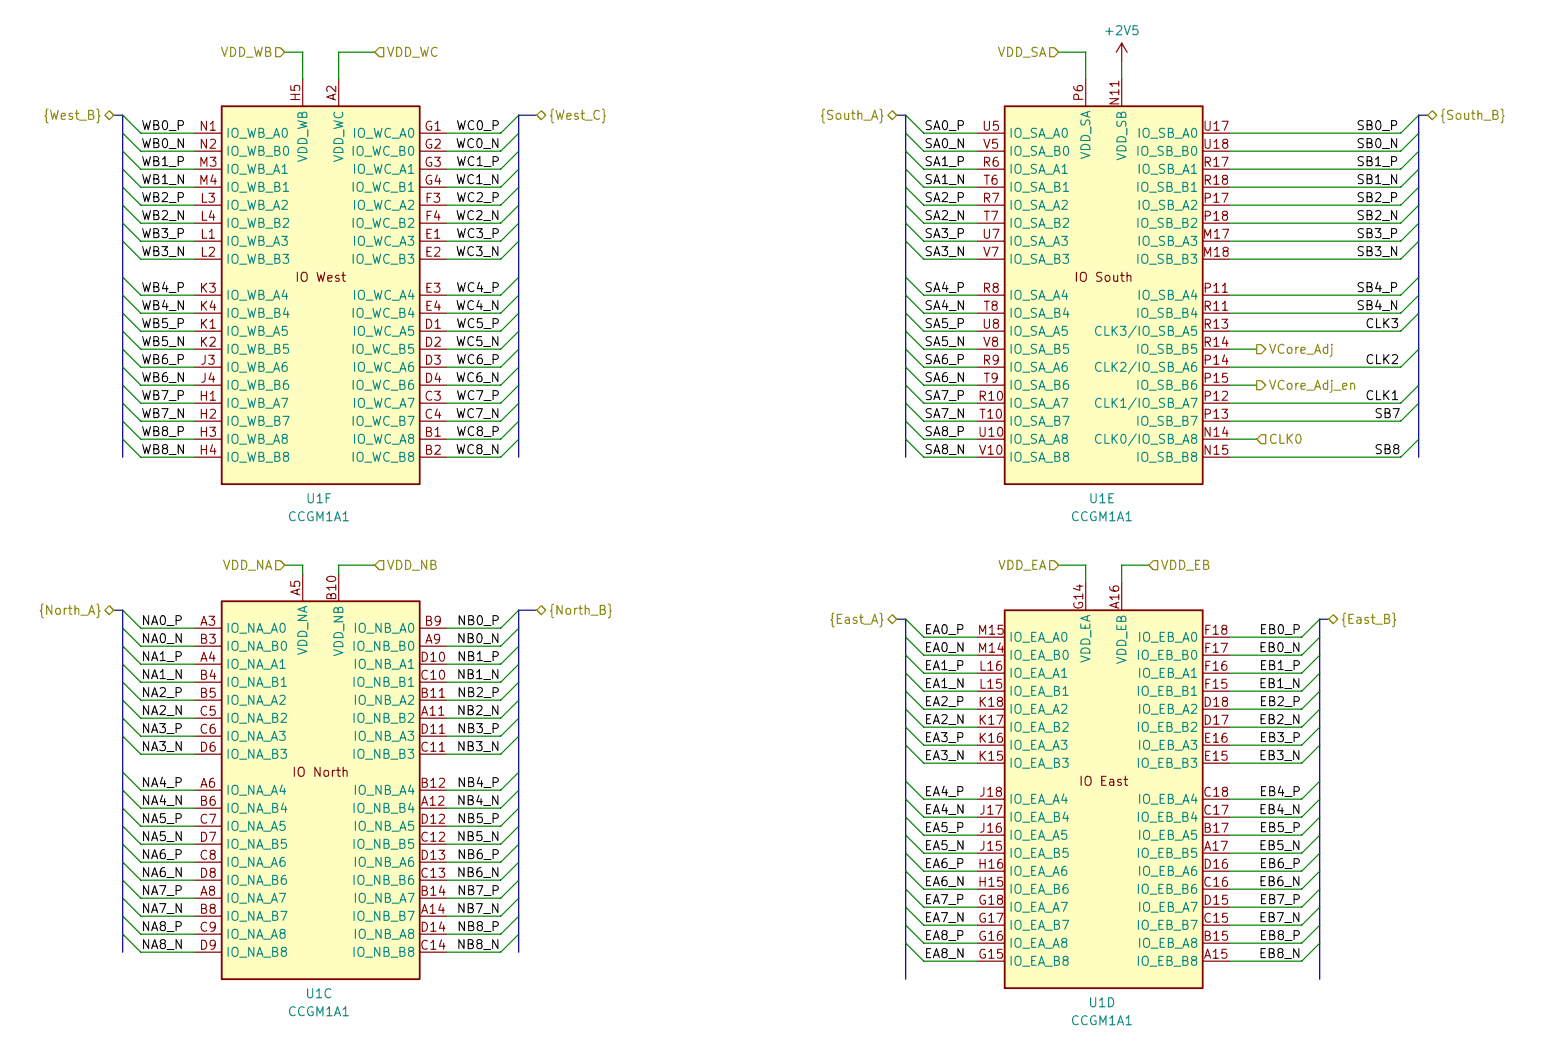
[picture p7: schematic FPGA_IO_Config.kicad_sch, CCSoM]

Parts:
U1: CCGM1A1; BGA-324_15x15mm_Layout18x18_P0.8mm; Mouser Part Number CCGM1A1-BGA324

Connections:
+2V5: U1.N11 (VDD_SB), U1.N13 (VDD_SB), U1.N18 (VDD_SB), U1.R15 (VDD_SB), U1.T18 (VDD_SB); also elsewhere on the board
/FPGA_Top_Module/CLK0: U1.N14 (CLK0/IO_SB_A8); also elsewhere on the board
/FPGA_Top_Module/CLK1: U1.P12 (CLK1/IO_SB_A7); also elsewhere on the board
/FPGA_Top_Module/CLK2: U1.P14 (CLK2/IO_SB_A6); also elsewhere on the board
/FPGA_Top_Module/CLK3: U1.R13 (CLK3/IO_SB_A5); also elsewhere on the board
/FPGA_Top_Module/EA0_N: U1.M14 (IO_EA_B0); also elsewhere on the board
/FPGA_Top_Module/EA0_P: U1.M15 (IO_EA_A0); also elsewhere on the board
/FPGA_Top_Module/EA1_N: U1.L15 (IO_EA_B1); also elsewhere on the board
/FPGA_Top_Module/EA1_P: U1.L16 (IO_EA_A1); also elsewhere on the board
/FPGA_Top_Module/EA2_N: U1.K17 (IO_EA_B2); also elsewhere on the board
/FPGA_Top_Module/EA2_P: U1.K18 (IO_EA_A2); also elsewhere on the board
/FPGA_Top_Module/EA3_N: U1.K15 (IO_EA_B3); also elsewhere on the board
/FPGA_Top_Module/EA3_P: U1.K16 (IO_EA_A3); also elsewhere on the board
/FPGA_Top_Module/EA4_N: U1.J17 (IO_EA_B4); also elsewhere on the board
/FPGA_Top_Module/EA4_P: U1.J18 (IO_EA_A4); also elsewhere on the board
/FPGA_Top_Module/EA5_N: U1.J15 (IO_EA_B5); also elsewhere on the board
/FPGA_Top_Module/EA5_P: U1.J16 (IO_EA_A5); also elsewhere on the board
/FPGA_Top_Module/EA6_N: U1.H15 (IO_EA_B6); also elsewhere on the board
/FPGA_Top_Module/EA6_P: U1.H16 (IO_EA_A6); also elsewhere on the board
/FPGA_Top_Module/EA7_N: U1.G17 (IO_EA_B7); also elsewhere on the board
/FPGA_Top_Module/EA7_P: U1.G18 (IO_EA_A7); also elsewhere on the board
/FPGA_Top_Module/EA8_N: U1.G15 (IO_EA_B8); also elsewhere on the board
/FPGA_Top_Module/EA8_P: U1.G16 (IO_EA_A8); also elsewhere on the board
/FPGA_Top_Module/EB0_N: U1.F17 (IO_EB_B0); also elsewhere on the board
/FPGA_Top_Module/EB0_P: U1.F18 (IO_EB_A0); also elsewhere on the board
/FPGA_Top_Module/EB1_N: U1.F15 (IO_EB_B1); also elsewhere on the board
/FPGA_Top_Module/EB1_P: U1.F16 (IO_EB_A1); also elsewhere on the board
/FPGA_Top_Module/EB2_N: U1.D17 (IO_EB_B2); also elsewhere on the board
/FPGA_Top_Module/EB2_P: U1.D18 (IO_EB_A2); also elsewhere on the board
/FPGA_Top_Module/EB3_N: U1.E15 (IO_EB_B3); also elsewhere on the board
/FPGA_Top_Module/EB3_P: U1.E16 (IO_EB_A3); also elsewhere on the board
/FPGA_Top_Module/EB4_N: U1.C17 (IO_EB_B4); also elsewhere on the board
/FPGA_Top_Module/EB4_P: U1.C18 (IO_EB_A4); also elsewhere on the board
/FPGA_Top_Module/EB5_N: U1.A17 (IO_EB_B5); also elsewhere on the board
/FPGA_Top_Module/EB5_P: U1.B17 (IO_EB_A5); also elsewhere on the board
/FPGA_Top_Module/EB6_N: U1.C16 (IO_EB_B6); also elsewhere on the board
/FPGA_Top_Module/EB6_P: U1.D16 (IO_EB_A6); also elsewhere on the board
/FPGA_Top_Module/EB7_N: U1.C15 (IO_EB_B7); also elsewhere on the board
/FPGA_Top_Module/EB7_P: U1.D15 (IO_EB_A7); also elsewhere on the board
/FPGA_Top_Module/EB8_N: U1.A15 (IO_EB_B8); also elsewhere on the board
/FPGA_Top_Module/EB8_P: U1.B15 (IO_EB_A8); also elsewhere on the board
/FPGA_Top_Module/FPGA_IO_Config/VDD_EA: U1.G14 (VDD_EA), U1.H17 (VDD_EA), U1.J14 (VDD_EA), U1.L14 (VDD_EA), U1.L17 (VDD_EA); also elsewhere on the board
/FPGA_Top_Module/FPGA_IO_Config/VDD_EB: U1.A16 (VDD_EB), U1.B18 (VDD_EB), U1.E14 (VDD_EB), U1.E17 (VDD_EB), U1.F13 (VDD_EB); also elsewhere on the board
/FPGA_Top_Module/FPGA_IO_Config/VDD_NA: U1.A5 (VDD_NA), U1.B7 (VDD_NA), U1.E6 (VDD_NA), U1.E8 (VDD_NA), U1.F7 (VDD_NA); also elsewhere on the board
/FPGA_Top_Module/FPGA_IO_Config/VDD_NB: U1.B10 (VDD_NB), U1.B13 (VDD_NB), U1.E10 (VDD_NB), U1.E12 (VDD_NB), U1.F11 (VDD_NB); also elsewhere on the board
/FPGA_Top_Module/FPGA_IO_Config/VDD_SA: U1.P6 (VDD_SA), U1.P8 (VDD_SA), U1.P10 (VDD_SA), U1.U6 (VDD_SA), U1.U9 (VDD_SA); also elsewhere on the board
/FPGA_Top_Module/FPGA_IO_Config/VDD_WB: U1.H5 (VDD_WB), U1.J2 (VDD_WB), U1.K5 (VDD_WB), U1.M2 (VDD_WB), U1.M5 (VDD_WB); also elsewhere on the board
/FPGA_Top_Module/FPGA_IO_Config/VDD_WC: U1.A2 (VDD_WC), U1.C2 (VDD_WC), U1.D5 (VDD_WC), U1.F2 (VDD_WC), U1.F5 (VDD_WC); also elsewhere on the board
/FPGA_Top_Module/NA0_N: U1.B3 (IO_NA_B0); also elsewhere on the board
/FPGA_Top_Module/NA0_P: U1.A3 (IO_NA_A0); also elsewhere on the board
/FPGA_Top_Module/NA1_N: U1.B4 (IO_NA_B1); also elsewhere on the board
/FPGA_Top_Module/NA1_P: U1.A4 (IO_NA_A1); also elsewhere on the board
/FPGA_Top_Module/NA2_N: U1.C5 (IO_NA_B2); also elsewhere on the board
/FPGA_Top_Module/NA2_P: U1.B5 (IO_NA_A2); also elsewhere on the board
/FPGA_Top_Module/NA3_N: U1.D6 (IO_NA_B3); also elsewhere on the board
/FPGA_Top_Module/NA3_P: U1.C6 (IO_NA_A3); also elsewhere on the board
/FPGA_Top_Module/NA4_N: U1.B6 (IO_NA_B4); also elsewhere on the board
/FPGA_Top_Module/NA4_P: U1.A6 (IO_NA_A4); also elsewhere on the board
/FPGA_Top_Module/NA5_N: U1.D7 (IO_NA_B5); also elsewhere on the board
/FPGA_Top_Module/NA5_P: U1.C7 (IO_NA_A5); also elsewhere on the board
/FPGA_Top_Module/NA6_N: U1.D8 (IO_NA_B6); also elsewhere on the board
/FPGA_Top_Module/NA6_P: U1.C8 (IO_NA_A6); also elsewhere on the board
/FPGA_Top_Module/NA7_N: U1.B8 (IO_NA_B7); also elsewhere on the board
/FPGA_Top_Module/NA7_P: U1.A8 (IO_NA_A7); also elsewhere on the board
/FPGA_Top_Module/NA8_N: U1.D9 (IO_NA_B8); also elsewhere on the board
/FPGA_Top_Module/NA8_P: U1.C9 (IO_NA_A8); also elsewhere on the board
/FPGA_Top_Module/NB0_N: U1.A9 (IO_NB_B0); also elsewhere on the board
/FPGA_Top_Module/NB0_P: U1.B9 (IO_NB_A0); also elsewhere on the board
/FPGA_Top_Module/NB1_N: U1.C10 (IO_NB_B1); also elsewhere on the board
/FPGA_Top_Module/NB1_P: U1.D10 (IO_NB_A1); also elsewhere on the board
/FPGA_Top_Module/NB2_N: U1.A11 (IO_NB_B2); also elsewhere on the board
/FPGA_Top_Module/NB2_P: U1.B11 (IO_NB_A2); also elsewhere on the board
/FPGA_Top_Module/NB3_N: U1.C11 (IO_NB_B3); also elsewhere on the board
/FPGA_Top_Module/NB3_P: U1.D11 (IO_NB_A3); also elsewhere on the board
/FPGA_Top_Module/NB4_N: U1.A12 (IO_NB_B4); also elsewhere on the board
/FPGA_Top_Module/NB4_P: U1.B12 (IO_NB_A4); also elsewhere on the board
/FPGA_Top_Module/NB5_N: U1.C12 (IO_NB_B5); also elsewhere on the board
/FPGA_Top_Module/NB5_P: U1.D12 (IO_NB_A5); also elsewhere on the board
/FPGA_Top_Module/NB6_N: U1.C13 (IO_NB_B6); also elsewhere on the board
/FPGA_Top_Module/NB6_P: U1.D13 (IO_NB_A6); also elsewhere on the board
/FPGA_Top_Module/NB7_N: U1.A14 (IO_NB_B7); also elsewhere on the board
/FPGA_Top_Module/NB7_P: U1.B14 (IO_NB_A7); also elsewhere on the board
/FPGA_Top_Module/NB8_N: U1.C14 (IO_NB_B8); also elsewhere on the board
/FPGA_Top_Module/NB8_P: U1.D14 (IO_NB_A8); also elsewhere on the board
/FPGA_Top_Module/SA0_N: U1.V5 (IO_SA_B0); also elsewhere on the board
/FPGA_Top_Module/SA0_P: U1.U5 (IO_SA_A0); also elsewhere on the board
/FPGA_Top_Module/SA1_N: U1.T6 (IO_SA_B1); also elsewhere on the board
/FPGA_Top_Module/SA1_P: U1.R6 (IO_SA_A1); also elsewhere on the board
/FPGA_Top_Module/SA2_N: U1.T7 (IO_SA_B2); also elsewhere on the board
/FPGA_Top_Module/SA2_P: U1.R7 (IO_SA_A2); also elsewhere on the board
/FPGA_Top_Module/SA3_N: U1.V7 (IO_SA_B3); also elsewhere on the board
/FPGA_Top_Module/SA3_P: U1.U7 (IO_SA_A3); also elsewhere on the board
/FPGA_Top_Module/SA4_N: U1.T8 (IO_SA_B4); also elsewhere on the board
/FPGA_Top_Module/SA4_P: U1.R8 (IO_SA_A4); also elsewhere on the board
/FPGA_Top_Module/SA5_N: U1.V8 (IO_SA_B5); also elsewhere on the board
/FPGA_Top_Module/SA5_P: U1.U8 (IO_SA_A5); also elsewhere on the board
/FPGA_Top_Module/SA6_N: U1.T9 (IO_SA_B6); also elsewhere on the board
/FPGA_Top_Module/SA6_P: U1.R9 (IO_SA_A6); also elsewhere on the board
/FPGA_Top_Module/SA7_N: U1.T10 (IO_SA_B7); also elsewhere on the board
/FPGA_Top_Module/SA7_P: U1.R10 (IO_SA_A7); also elsewhere on the board
/FPGA_Top_Module/SA8_N: U1.V10 (IO_SA_B8); also elsewhere on the board
/FPGA_Top_Module/SA8_P: U1.U10 (IO_SA_A8); also elsewhere on the board
/FPGA_Top_Module/SB0_N: U1.U18 (IO_SB_B0); also elsewhere on the board
/FPGA_Top_Module/SB0_P: U1.U17 (IO_SB_A0); also elsewhere on the board
/FPGA_Top_Module/SB1_N: U1.R18 (IO_SB_B1); also elsewhere on the board
/FPGA_Top_Module/SB1_P: U1.R17 (IO_SB_A1); also elsewhere on the board
/FPGA_Top_Module/SB2_N: U1.P18 (IO_SB_B2); also elsewhere on the board
/FPGA_Top_Module/SB2_P: U1.P17 (IO_SB_A2); also elsewhere on the board
/FPGA_Top_Module/SB3_N: U1.M18 (IO_SB_B3); also elsewhere on the board
/FPGA_Top_Module/SB3_P: U1.M17 (IO_SB_A3); also elsewhere on the board
/FPGA_Top_Module/SB4_N: U1.R11 (IO_SB_B4); also elsewhere on the board
/FPGA_Top_Module/SB4_P: U1.P11 (IO_SB_A4); also elsewhere on the board
/FPGA_Top_Module/SB7: U1.P13 (IO_SB_B7); also elsewhere on the board
/FPGA_Top_Module/SB8: U1.N15 (IO_SB_B8); also elsewhere on the board
/FPGA_Top_Module/VcAdj: U1.R14 (IO_SB_B5); also elsewhere on the board
/FPGA_Top_Module/WB0_N: U1.N2 (IO_WB_B0); also elsewhere on the board
/FPGA_Top_Module/WB0_P: U1.N1 (IO_WB_A0); also elsewhere on the board
/FPGA_Top_Module/WB1_N: U1.M4 (IO_WB_B1); also elsewhere on the board
/FPGA_Top_Module/WB1_P: U1.M3 (IO_WB_A1); also elsewhere on the board
/FPGA_Top_Module/WB2_N: U1.L4 (IO_WB_B2); also elsewhere on the board
/FPGA_Top_Module/WB2_P: U1.L3 (IO_WB_A2); also elsewhere on the board
/FPGA_Top_Module/WB3_N: U1.L2 (IO_WB_B3); also elsewhere on the board
/FPGA_Top_Module/WB3_P: U1.L1 (IO_WB_A3); also elsewhere on the board
/FPGA_Top_Module/WB4_N: U1.K4 (IO_WB_B4); also elsewhere on the board
/FPGA_Top_Module/WB4_P: U1.K3 (IO_WB_A4); also elsewhere on the board
/FPGA_Top_Module/WB5_N: U1.K2 (IO_WB_B5); also elsewhere on the board
/FPGA_Top_Module/WB5_P: U1.K1 (IO_WB_A5); also elsewhere on the board
/FPGA_Top_Module/WB6_N: U1.J4 (IO_WB_B6); also elsewhere on the board
/FPGA_Top_Module/WB6_P: U1.J3 (IO_WB_A6); also elsewhere on the board
/FPGA_Top_Module/WB7_N: U1.H2 (IO_WB_B7); also elsewhere on the board
/FPGA_Top_Module/WB7_P: U1.H1 (IO_WB_A7); also elsewhere on the board
/FPGA_Top_Module/WB8_N: U1.H4 (IO_WB_B8); also elsewhere on the board
/FPGA_Top_Module/WB8_P: U1.H3 (IO_WB_A8); also elsewhere on the board
/FPGA_Top_Module/WC0_N: U1.G2 (IO_WC_B0); also elsewhere on the board
/FPGA_Top_Module/WC0_P: U1.G1 (IO_WC_A0); also elsewhere on the board
/FPGA_Top_Module/WC1_N: U1.G4 (IO_WC_B1); also elsewhere on the board
/FPGA_Top_Module/WC1_P: U1.G3 (IO_WC_A1); also elsewhere on the board
/FPGA_Top_Module/WC2_N: U1.F4 (IO_WC_B2); also elsewhere on the board
/FPGA_Top_Module/WC2_P: U1.F3 (IO_WC_A2); also elsewhere on the board
/FPGA_Top_Module/WC3_N: U1.E2 (IO_WC_B3); also elsewhere on the board
/FPGA_Top_Module/WC3_P: U1.E1 (IO_WC_A3); also elsewhere on the board
/FPGA_Top_Module/WC4_N: U1.E4 (IO_WC_B4); also elsewhere on the board
/FPGA_Top_Module/WC4_P: U1.E3 (IO_WC_A4); also elsewhere on the board
/FPGA_Top_Module/WC5_N: U1.D2 (IO_WC_B5); also elsewhere on the board
/FPGA_Top_Module/WC5_P: U1.D1 (IO_WC_A5); also elsewhere on the board
/FPGA_Top_Module/WC6_N: U1.D4 (IO_WC_B6); also elsewhere on the board
/FPGA_Top_Module/WC6_P: U1.D3 (IO_WC_A6); also elsewhere on the board
/FPGA_Top_Module/WC7_N: U1.C4 (IO_WC_B7); also elsewhere on the board
/FPGA_Top_Module/WC7_P: U1.C3 (IO_WC_A7); also elsewhere on the board
/FPGA_Top_Module/WC8_N: U1.B2 (IO_WC_B8); also elsewhere on the board
/FPGA_Top_Module/WC8_P: U1.B1 (IO_WC_A8); also elsewhere on the board
/FPGA_Top_Module/~VcAen: U1.P15 (IO_SB_B6); also elsewhere on the board

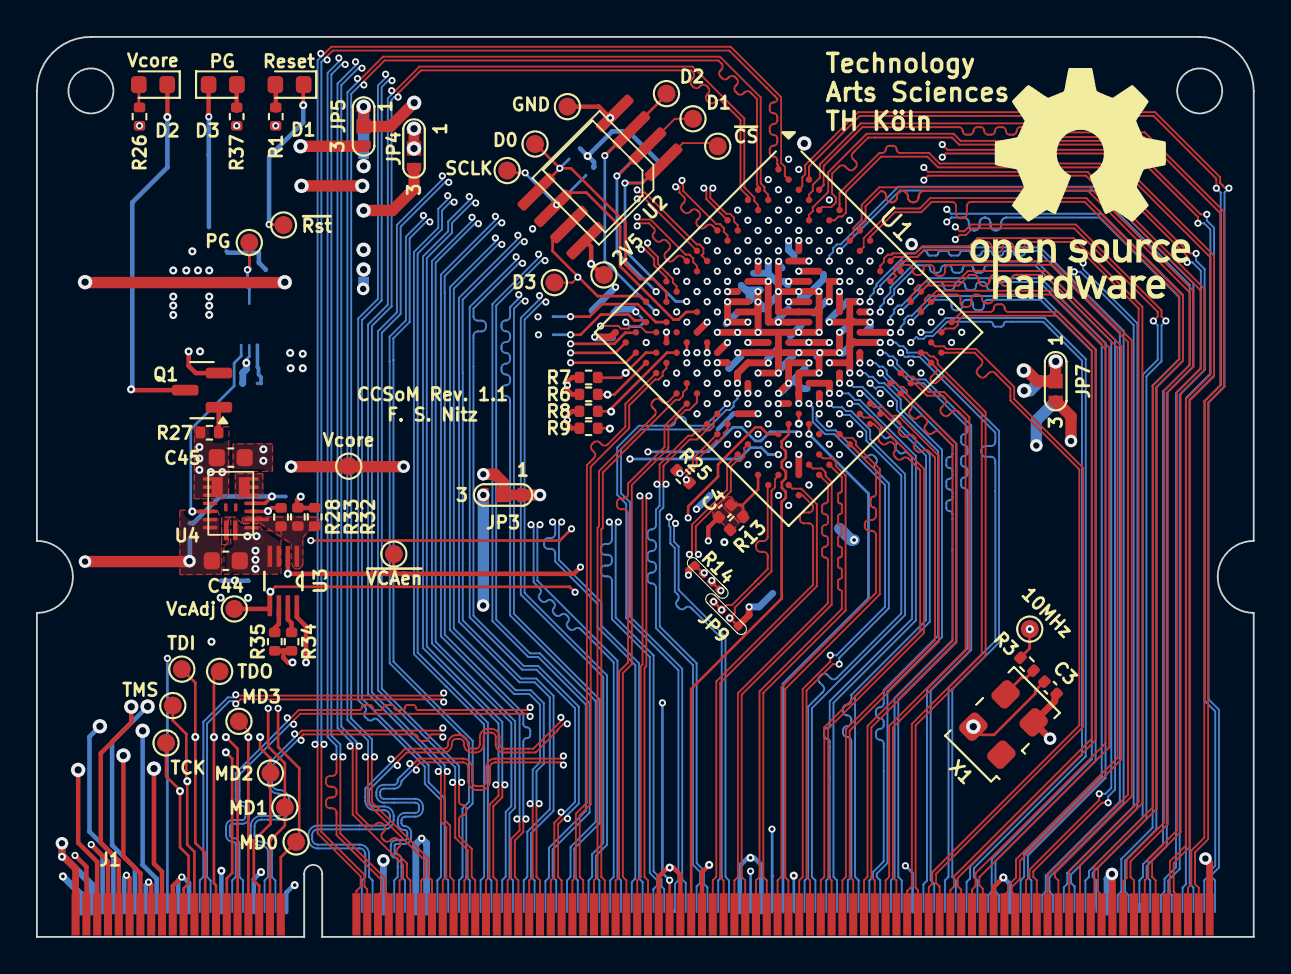
[picture p8: board SOM.kicad_pcb from above]

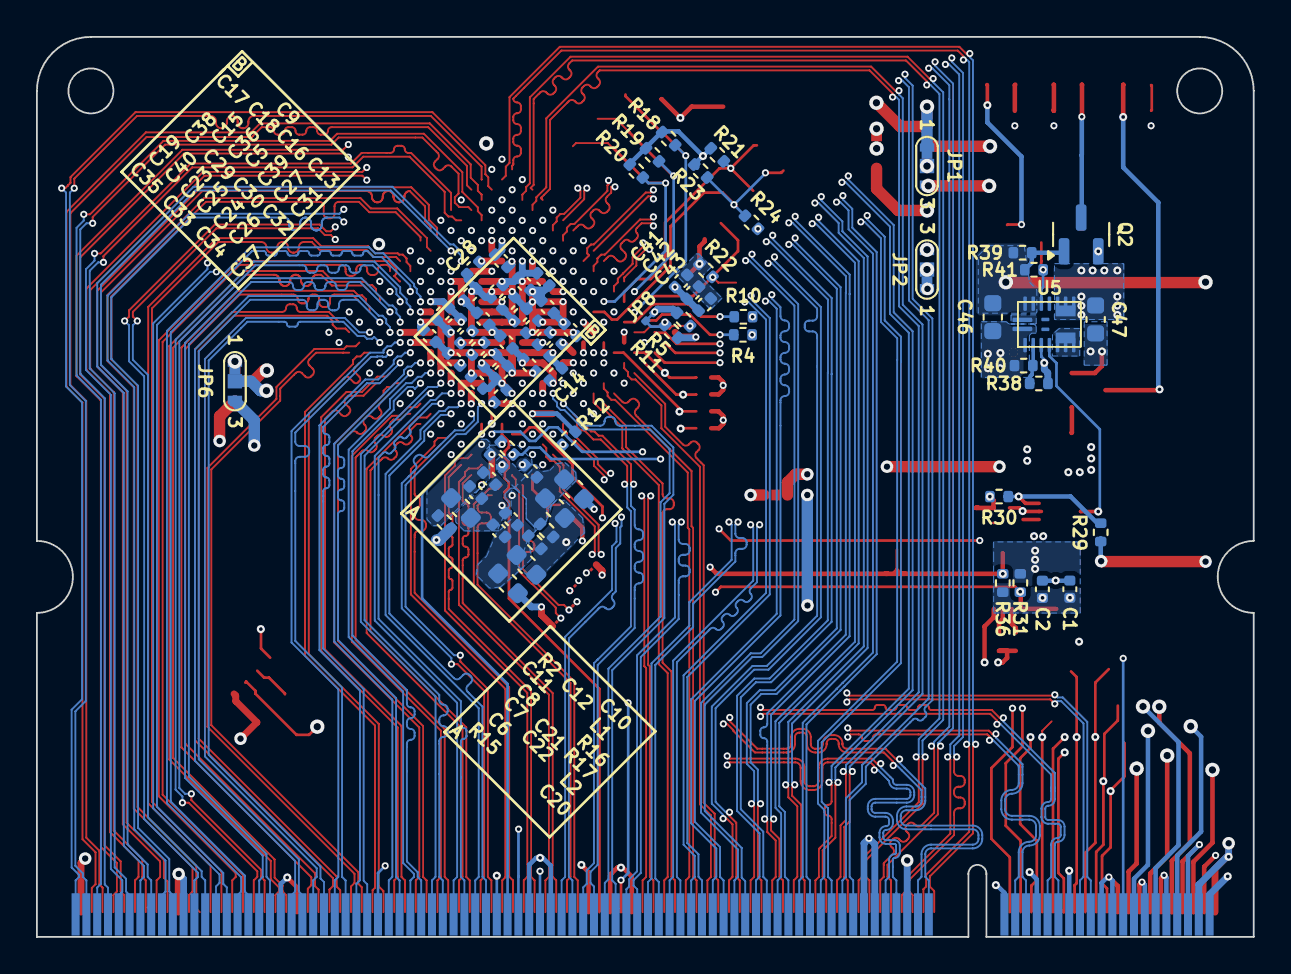
[picture p9: board SOM.kicad_pcb from below]

Board: 6 copper layers, 67.6 x 50.0 mm, 135 parts (75 on the bottom side), 212 nets.
