swittlich/CcSoM/Baseboards/SoMProgrammerNTester/SoMProgrammerNTester.kicad_pcb

## KiCad design Baseboards/SoMProgrammerNTester/SoMProgrammerNTester.kicad_pcb (2026-09-22)

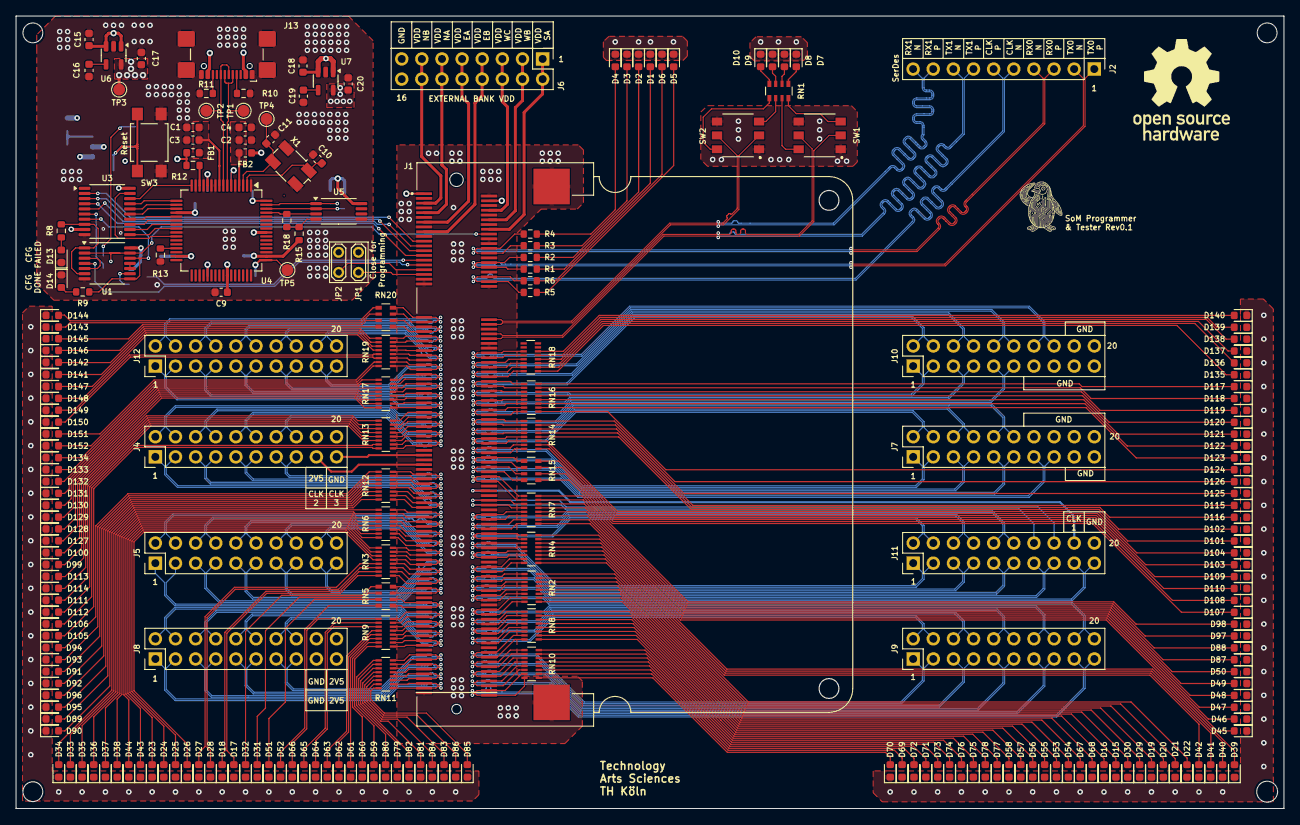
[picture p10: board SoMProgrammerNTester.kicad_pcb from above]

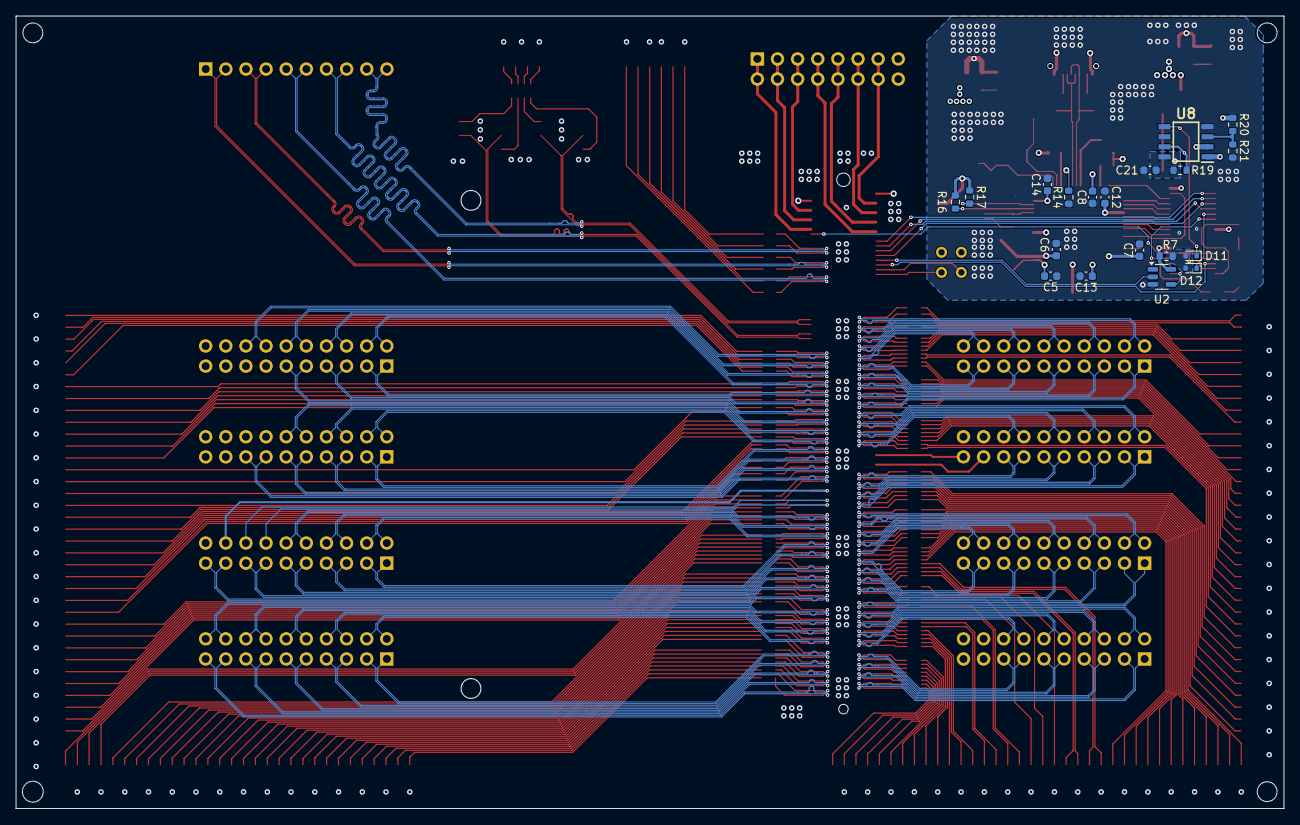
[picture p11: board SoMProgrammerNTester.kicad_pcb from below]

Board: 4 copper layers, 160.0 x 100.0 mm, 249 parts (19 on the bottom side), 361 nets.

Parts:
C1, C2: 4.7uF; C_0603_1608Metric
C3, C4, C6, C7, C8, C9, C12, C13, C14, C15, C17, C18, C20, C21: 0.1uF; C_0603_1608Metric
C5: 3.3uF; C_0603_1608Metric
C10, C11: 10pF; C_0603_1608Metric
C16, C19: 10nF; C_0603_1608Metric
D1, D2, D3, D4, D5, D6, D7, D8, D9, D10, D14, D15, D16, D17, D18, D19, D20, D21, D22, D23, D24, D25, D26, D27, D28, D29, D30, D31, D32, D33, D34, D35, D36, D37, D38, D39, D40, D41, D42, D43, D44, D45, D46, D47, D48, D49, D50, D51, D52, D53, D54, D55, D56, D57, D58, D59, D60, D61, D62, D63, D64, D65, D66, D67, D68, D69, D70, D71, D72, D73, D74, D75, D76, D77, D78, D79, D80, D81, D82, D83, D84, D85, D86, D87, D88, D89, D90, D91, D92, D93, D94, D95, D96, D97, D98, D99, D100, D101, D102, D103, D104, D105, D106, D107, D108, D109, D110, D111, D112, D113, D114, D115, D116, D117, D118, D119, D120, D121, D122, D123, D124, D125, D126, D127, D128, D129, D130, D131, D132, D133, D134, D135, D136, D137, D138, D139, D140, D141, D142, D143, D144, D145, D146, D147, D148, D149, D150, D151, D152: Green; LED_0603_1608Metric
D11, D12: 1N4148WT; D_SOD-523
D13: RED; LED_0603_1608Metric
FB1, FB2: 600R, 0.5A; L_0603_1608Metric
J1: SoM Connector; SoM_Connector
J2: Conn_01x12_Pin; PinHeader_1x10_P2.54mm_Vertical
J4, J5, J7, J8, J9, J10, J11, J12: Conn_02x10_Odd_Even; PinHeader_2x10_P2.54mm_Vertical
J6: Conn_02x8_Odd_Even; PinHeader_2x08_P2.54mm_Vertical
J13: USB_C_Receptacle_USB2.0_16P; USB_C_Receptacle_GCT_USB4110
JP1, JP2: Jumper_2_Small_Bridged; TestPoint_2Pads_Pitch2.54mm_Drill0.8mm
R1, R2, R3, R4, R5, R6, R8, R9: 200R; R_0603_1608Metric
R7, R19: 47K; R_0603_1608Metric
R10, R11: 5K1; R_0603_1608Metric
R12: 1K; R_0603_1608Metric
R13, R14: 12K; R_0603_1608Metric
R15, R16, R17: 10K; R_0603_1608Metric
R18: 2K; R_0603_1608Metric
R20: 270K; R_0603_1608Metric
R21: 470K; R_0603_1608Metric
RN1, RN5, RN15, RN20: 200R; R_Array_Convex_4x0603
RN2, RN3, RN4, RN6, RN7, RN8, RN9, RN10, RN11, RN12, RN13, RN14, RN16, RN17, RN18, RN19: 200R; R_Array_Convex_8x0602
SW1, SW2: CAS-D20TB; CASD20TB
SW3: SW_Push; SW_SPST_TL3305A
TP1: USB_D-; TestPoint_Pad_D1.5mm
TP2: USB_D+; TestPoint_Pad_D1.5mm
TP3: +3V3; TestPoint_Pad_D1.5mm
TP4: 12MHz; TestPoint_Pad_D1.5mm
TP5: +1V8_FTDI; TestPoint_Pad_D1.5mm
U1: SN74LVC00APWE4; TSSOP-14_4.4x5mm_P0.65mm
U2: 74AUP1G04; SOT-23-5
U3: SN74CB3T3245PWR; TSSOP-20_4.4x6.5mm_P0.65mm
U4: FT2232HL; LQFP-64_10x10mm_P0.5mm
U5: 93LC46B; TSSOP-8_4.4x3mm_P0.65mm
U6: TPS73633DBV; SOT-23-5
U7: TPS73625DBV; SOT-23-5
U8: TPS3307-33DR; SOIC-8_5.8x3.81mm
X1: 12MHz; Crystal_SMD_Abracon_ABM3B-4Pin_5.0x3.2mm
log1: PinguinLogo
log2: OpenHardwareLogo

Connections:
+1V8_FTDI: C5.1, C12.1, C13.1, C14.1, TP5.1, U4.12 (VCORE), U4.37 (VCORE), U4.49 (VREGOUT), U4.64 (VCORE)
+2V5: C20.1, C21.1, J4.18, J8.19, J8.20, JP1.1 (A), JP2.1 (A), R7.1, R19.1, R20.1, U1.14 (VCC), U2.5 (VCC), U3.9 (A8), U3.20 (VCC), U7.5 (OUT), U8.8 (VDD)
+3V3: C6.1, C7.1, C8.1, C9.1, C17.1, FB1.1, FB2.1, R12.1, R15.1, R16.1, R17.1, TP3.1, U4.20 (VCCIO), U4.31 (VCCIO), U4.42 (VCCIO), U4.50 (VREGIN), U4.56 (VCCIO), U5.8 (VCC), U6.5 (OUT), U8.2 (SENSE2)
+5V: C15.1, C18.1, J1.1 (+5V), J1.4 (+5V), J13.A4 (VBUS), J13.A9 (VBUS), J13.B4 (VBUS), J13.B9 (VBUS), U6.1 (IN), U6.3 (EN), U7.1 (IN), U7.3 (EN), U8.1 (SENSE1)
/CFG_Done: J1.29 (CFG_Done), U2.2
/CLK1: J1.114 (CLK1), J11.18
/CLK2: J1.103 (CLK2), J4.17
/CLK3: J1.99 (CLK3), J4.19
/CLK_N: J1.38 (CLK_N), J2.5, R5.1
/CLK_P: J1.36 (CLK_P), J2.6, R6.1
/DONE: R9.1, U1.8 (3Y), U1.12 (4A), U3.7 (A6)
/FTDI/FTDI_EEPROM_CS: R17.2, U4.63 (EECS), U5.1 (CS)
/FTDI/JTAG_RST: D12.1 (K), U3.6 (A5)
/FTDI/JTAG_TCK: J1.21 (JTAG_TCK), U3.2 (A1)
/FTDI/JTAG_TDI: J1.25 (JTAG_TDI), U3.3 (A2)
/FTDI/JTAG_TDO: J1.27 (JTAG_TDO), U3.4 (A3)
/FTDI/JTAG_TMS: J1.23 (JTAG_TMS), U3.5 (A4)
/Header Interface/EA0_N: J1.123 (EA0_N), J5.2, RN6.8 (R8.1)
/Header Interface/EA0_P: J1.125 (EA0_P), J5.4, RN6.7 (R7.1)
/Header Interface/EA1_N: J1.126 (EA1_N), J11.10, RN7.14 (R3.2)
/Header Interface/EA1_P: J1.124 (EA1_P), J11.12, RN7.13 (R4.2)
/Header Interface/EA2_N: J1.129 (EA2_N), J5.8, RN6.5 (R5.1)
/Header Interface/EA2_P: J1.127 (EA2_P), J5.6, RN6.6 (R6.1)
/Header Interface/EA3_N: J1.130 (EA3_N), J11.6, RN7.16 (R1.2)
/Header Interface/EA3_P: J1.128 (EA3_P), J11.8, RN7.15 (R2.2)
/Header Interface/EA4_N: J1.133 (EA4_N), J5.12, RN6.3 (R3.1)
/Header Interface/EA4_P: J1.131 (EA4_P), J5.10, RN6.4 (R4.1)
/Header Interface/EA5_N: J1.134 (EA5_N), J11.2, RN4.10 (R7.2)
/Header Interface/EA5_P: J1.132 (EA5_P), J11.4, RN4.9 (R8.2)
/Header Interface/EA6_N: J1.138 (EA6_N), J11.3, RN4.12 (R5.2)
/Header Interface/EA6_P: J1.136 (EA6_P), J11.1, RN4.11 (R6.2)
/Header Interface/EA7_N: J1.137 (EA7_N), J5.16, RN6.1 (R1.1)
/Header Interface/EA7_P: J1.135 (EA7_P), J5.14, RN6.2 (R2.1)
/Header Interface/EA8_N: J1.142 (EA8_N), J11.7, RN4.14 (R3.2)
/Header Interface/EA8_P: J1.140 (EA8_P), J11.5, RN4.13 (R4.2)
/Header Interface/EB0_N: J1.141 (EB0_N), J5.20, RN3.15 (R2.2)
/Header Interface/EB0_P: J1.139 (EB0_P), J5.18, RN3.16 (R1.2)
/Header Interface/EB1_N: J1.148 (EB1_N), J11.11, RN4.16 (R1.2)
/Header Interface/EB1_P: J1.146 (EB1_P), J11.9, RN4.15 (R2.2)
/Header Interface/EB2_N: J1.145 (EB2_N), J5.17, RN3.13 (R4.2)
/Header Interface/EB2_P: J1.143 (EB2_P), J5.19, RN3.14 (R3.2)
/Header Interface/EB3_N: J1.152 (EB3_N), J11.15, RN2.10 (R7.2)
/Header Interface/EB3_P: J1.150 (EB3_P), J11.13, RN2.9 (R8.2)
/Header Interface/EB4_N: J1.149 (EB4_N), J5.13, RN3.11 (R6.2)
/Header Interface/EB4_P: J1.147 (EB4_P), J5.15, RN3.12 (R5.2)
/Header Interface/EB5_N: J1.153 (EB5_N), J5.9, RN3.9 (R8.2)
/Header Interface/EB5_P: J1.151 (EB5_P), J5.11, RN3.10 (R7.2)
/Header Interface/EB6_N: J1.156 (EB6_N), J11.19, RN2.12 (R5.2)
/Header Interface/EB6_P: J1.154 (EB6_P), J11.17, RN2.11 (R6.2)
/Header Interface/EB7_N: J1.158 (EB7_N), J9.20, RN2.13 (R4.2)
/Header Interface/EB7_P: J1.160 (EB7_P), J9.18, RN2.14 (R3.2)
/Header Interface/EB8_N: J1.155 (EB8_N), J5.7, RN5.8 (R1.2)
/Header Interface/EB8_P: J1.157 (EB8_P), J5.5, RN5.7 (R2.2)
/Header Interface/Eastbank/VDD_EA: J1.13 (VDD_EA), J6.9, J6.10
/Header Interface/Eastbank/VDD_EB: J1.17 (VDD_EB), J6.7, J6.8
/Header Interface/NA0_N: J1.200 (NA0_N), J9.19, RN10.8 (R8.1)
/Header Interface/NA0_P: J1.198 (NA0_P), J9.17, RN10.7 (R7.1)
/Header Interface/NA1_N: J1.197 (NA1_N), J8.1, RN11.1 (R1.1)
/Header Interface/NA1_P: J1.195 (NA1_P), J8.3, RN11.2 (R2.1)
/Header Interface/NA2_N: J1.196 (NA2_N), J9.15, RN10.6 (R6.1)
/Header Interface/NA2_P: J1.194 (NA2_P), J9.13, RN10.5 (R5.1)
/Header Interface/NA3_N: J1.193 (NA3_N), J8.5, RN11.3 (R3.1)
/Header Interface/NA3_P: J1.191 (NA3_P), J8.7, RN11.4 (R4.1)
/Header Interface/NA4_N: J1.190 (NA4_N), J9.9, RN10.3 (R3.1)
/Header Interface/NA4_P: J1.192 (NA4_P), J9.11, RN10.4 (R4.1)
/Header Interface/NA5_N: J1.189 (NA5_N), J8.9, RN11.5 (R5.1)
/Header Interface/NA5_P: J1.187 (NA5_P), J8.11, RN11.6 (R6.1)
/Header Interface/NA6_N: J1.188 (NA6_N), J9.7, RN10.2 (R2.1)
/Header Interface/NA6_P: J1.186 (NA6_P), J9.5, RN10.1 (R1.1)
/Header Interface/NA7_N: J1.185 (NA7_N), J8.13, RN11.7 (R7.1)
/Header Interface/NA7_P: J1.183 (NA7_P), J8.15, RN11.8 (R8.1)
/Header Interface/NA8_N: J1.184 (NA8_N), J9.3, RN8.8 (R8.1)
/Header Interface/NA8_P: J1.182 (NA8_P), J9.1, RN8.7 (R7.1)
/Header Interface/NB0_N: J1.177 (NB0_N), J8.14, RN9.10 (R7.2)
/Header Interface/NB0_P: J1.179 (NB0_P), J8.16, RN9.9 (R8.2)
/Header Interface/NB1_N: J1.176 (NB1_N), J9.4, RN8.5 (R5.1)
/Header Interface/NB1_P: J1.178 (NB1_P), J9.2, RN8.6 (R6.1)
/Header Interface/NB2_N: J1.173 (NB2_N), J8.10, RN9.12 (R5.2)
/Header Interface/NB2_P: J1.175 (NB2_P), J8.12, RN9.11 (R6.2)
/Header Interface/NB3_N: J1.172 (NB3_N), J9.8, RN8.3 (R3.1)
/Header Interface/NB3_P: J1.174 (NB3_P), J9.6, RN8.4 (R4.1)
/Header Interface/NB4_N: J1.169 (NB4_N), J8.6, RN9.14 (R3.2)
/Header Interface/NB4_P: J1.171 (NB4_P), J8.8, RN9.13 (R4.2)
/Header Interface/NB5_N: J1.170 (NB5_N), J9.10, RN8.2 (R2.1)
/Header Interface/NB5_P: J1.168 (NB5_P), J9.12, RN8.1 (R1.1)
/Header Interface/NB6_N: J1.165 (NB6_N), J8.2, RN9.16 (R1.2)
/Header Interface/NB6_P: J1.167 (NB6_P), J8.4, RN9.15 (R2.2)
/Header Interface/NB7_N: J1.161 (NB7_N), J5.3, RN5.6 (R3.2)
/Header Interface/NB7_P: J1.163 (NB7_P), J5.1, RN5.5 (R4.2)
/Header Interface/NB8_N: J1.164 (NB8_N), J9.16, RN2.15 (R2.2)
/Header Interface/NB8_P: J1.166 (NB8_P), J9.14, RN2.16 (R1.2)
/Header Interface/Northbank/VDD_NA: J1.9 (VDD_NA), J6.11, J6.12
/Header Interface/Northbank/VDD_NB: J1.5 (VDD_NB), J6.13, J6.14
/Header Interface/SA0_N: J1.81 (SA0_N), J4.2, RN13.8 (R8.1)
/Header Interface/SA0_P: J1.83 (SA0_P), J4.4, RN13.7 (R7.1)
/Header Interface/SA1_N: J1.88 (SA1_N), J7.8, RN14.3 (R3.1)
/Header Interface/SA1_P: J1.90 (SA1_P), J7.6, RN14.4 (R4.1)
/Header Interface/SA2_N: J1.92 (SA2_N), J7.4, RN14.5 (R5.1)
/Header Interface/SA2_P: J1.94 (SA2_P), J7.2, RN14.6 (R6.1)
/Header Interface/SA3_N: J1.85 (SA3_N), J4.6, RN13.6 (R6.1)
/Header Interface/SA3_P: J1.87 (SA3_P), J4.8, RN13.5 (R5.1)
/Header Interface/SA4_N: J1.96 (SA4_N), J7.1, RN14.7 (R7.1)
/Header Interface/SA4_P: J1.98 (SA4_P), J7.3, RN14.8 (R8.1)
/Header Interface/SA5_N: J1.89 (SA5_N), J4.10, RN13.4 (R4.1)
/Header Interface/SA5_P: J1.91 (SA5_P), J4.12, RN13.3 (R3.1)
/Header Interface/SA6_N: J1.93 (SA6_N), J4.14, RN13.2 (R2.1)
/Header Interface/SA6_P: J1.95 (SA6_P), J4.16, RN13.1 (R1.1)
/Header Interface/SA7_N: J1.100 (SA7_N), J7.5, RN15.1 (R1.1)
/Header Interface/SA7_P: J1.102 (SA7_P), J7.7, RN15.2 (R2.1)
/Header Interface/SA8_N: J1.104 (SA8_N), J7.9, RN15.3 (R3.1)
/Header Interface/SA8_P: J1.106 (SA8_P), J7.11, RN15.4 (R4.1)
/Header Interface/SB0_N: J1.107 (SB0_N), J4.15, RN12.16 (R1.2)
/Header Interface/SB0_P: J1.109 (SB0_P), J4.13, RN12.15 (R2.2)
/Header Interface/SB1_N: J1.111 (SB1_N), J4.11, RN12.14 (R3.2)
/Header Interface/SB1_P: J1.113 (SB1_P), J4.9, RN12.13 (R4.2)
/Header Interface/SB2_N: J1.115 (SB2_N), J4.7, RN12.12 (R5.2)
/Header Interface/SB2_P: J1.117 (SB2_P), J4.5, RN12.11 (R6.2)
/Header Interface/SB3_N: J1.119 (SB3_N), J4.3, RN12.10 (R7.2)
/Header Interface/SB3_P: J1.121 (SB3_P), J4.1, RN12.9 (R8.2)
/Header Interface/SB4_N: J1.108 (SB4_N), J7.13, RN7.9 (R8.2)
/Header Interface/SB4_P: J1.110 (SB4_P), J7.15, RN7.10 (R7.2)
/Header Interface/SB7: J1.118 (SB7), J11.16, RN7.11 (R6.2)
/Header Interface/SB8: J1.120 (SB8), J11.14, RN7.12 (R5.2)
/Header Interface/Southbank/VDD_SA: J1.16 (VDD_SA), J6.1, J6.2
/Header Interface/WB0_N: J1.84 (WB0_N), J7.12, RN14.1 (R1.1)
/Header Interface/WB0_P: J1.86 (WB0_P), J7.10, RN14.2 (R2.1)
/Header Interface/WB1_N: J1.80 (WB1_N), J10.9, RN16.7 (R7.1)
/Header Interface/WB1_P: J1.82 (WB1_P), J10.11, RN16.8 (R8.1)
/Header Interface/WB2_N: J1.77 (WB2_N), J12.3, RN17.10 (R7.2)
/Header Interface/WB2_P: J1.79 (WB2_P), J12.1, RN17.9 (R8.2)
/Header Interface/WB3_N: J1.76 (WB3_N), J10.5, RN16.5 (R5.1)
/Header Interface/WB3_P: J1.78 (WB3_P), J10.7, RN16.6 (R6.1)
/Header Interface/WB4_N: J1.73 (WB4_N), J12.7, RN17.12 (R5.2)
/Header Interface/WB4_P: J1.75 (WB4_P), J12.5, RN17.11 (R6.2)
/Header Interface/WB5_N: J1.72 (WB5_N), J10.1, RN16.3 (R3.1)
/Header Interface/WB5_P: J1.74 (WB5_P), J10.3, RN16.4 (R4.1)
/Header Interface/WB6_N: J1.69 (WB6_N), J12.11, RN17.14 (R3.2)
/Header Interface/WB6_P: J1.71 (WB6_P), J12.9, RN17.13 (R4.2)
/Header Interface/WB7_N: J1.68 (WB7_N), J10.4, RN16.1 (R1.1)
/Header Interface/WB7_P: J1.70 (WB7_P), J10.2, RN16.2 (R2.1)
/Header Interface/WB8_N: J1.65 (WB8_N), J12.15, RN17.16 (R1.2)
/Header Interface/WB8_P: J1.67 (WB8_P), J12.13, RN17.15 (R2.2)
/Header Interface/WC0_N: J1.64 (WC0_N), J10.8, RN18.15 (R2.2)
/Header Interface/WC0_P: J1.66 (WC0_P), J10.6, RN18.16 (R1.2)
/Header Interface/WC1_N: J1.61 (WC1_N), J12.19, RN19.2 (R2.1)
/Header Interface/WC1_P: J1.63 (WC1_P), J12.17, RN19.1 (R1.1)
/Header Interface/WC2_N: J1.60 (WC2_N), J10.12, RN18.13 (R4.2)
/Header Interface/WC2_P: J1.62 (WC2_P), J10.10, RN18.14 (R3.2)
/Header Interface/WC3_N: J1.57 (WC3_N), J12.18, RN19.4 (R4.1)
/Header Interface/WC3_P: J1.59 (WC3_P), J12.20, RN19.3 (R3.1)
/Header Interface/WC4_N: J1.56 (WC4_N), J10.16, RN18.11 (R6.2)
/Header Interface/WC4_P: J1.58 (WC4_P), J10.14, RN18.12 (R5.2)
/Header Interface/WC5_N: J1.53 (WC5_N), J12.14, RN19.6 (R6.1)
/Header Interface/WC5_P: J1.55 (WC5_P), J12.16, RN19.5 (R5.1)
/Header Interface/WC6_N: J1.49 (WC6_N), J12.10, RN19.8 (R8.1)
/Header Interface/WC6_P: J1.51 (WC6_P), J12.12, RN19.7 (R7.1)
/Header Interface/WC7_N: J1.45 (WC7_N), J12.6, RN20.6 (R3.2)
/Header Interface/WC7_P: J1.47 (WC7_P), J12.8, RN20.5 (R4.2)
/Header Interface/WC8_N: J1.41 (WC8_N), J12.2, RN20.8 (R1.2)
/Header Interface/WC8_P: J1.43 (WC8_P), J12.4, RN20.7 (R2.2)
/Header Interface/Westbank/VDD_WB: J1.12 (VDD_WB), J6.3, J6.4
/Header Interface/Westbank/VDD_WC: J1.8 (VDD_WC), J6.5, J6.6
/Power supply/~WD_Reset: D11.1 (K), U8.5 (~RESET)
/RX0_N: J1.24 (RX_N0), J2.4, R4.1
/RX0_P: J1.26 (RX_P0), J2.3, R3.1
/RX1_N: J1.42 (RX_N1), J2.10, SW2.5
/RX1_P: J1.44 (RX_P1), J2.9, SW2.2
/TX0_N: J1.30 (TX_N0), J2.2, R2.1
/TX0_P: J1.32 (TX_P0), J2.1, R1.1
/TX1_N: J1.48 (TX_N1), J2.8, SW1.5
/TX1_P: J1.50 (TX_P1), J2.7, SW1.2
/~CFG_Failed: J1.31 (CFG_Failed), U1.4 (2A)
/~FAILED: R8.1, U1.1 (1A), U1.6 (2Y), U3.8 (A7)
/~Rst: D11.2 (A), D12.2 (A), J1.18 (APP_Reset), R7.2, U1.2 (1B), U1.13 (4B)
GND: C1.2, C2.2, C3.2, C4.2, C5.2, C6.2, C7.2, C8.2, C9.2, C10.2, C11.2, C12.2, C13.2, C14.2, C15.2, C16.2, C17.2, C18.2, C19.2, C20.2, C21.2, D1.1 (K), D2.1 (K), D3.1 (K), D4.1 (K), D5.1 (K), D6.1 (K), D7.1 (K), D8.1 (K), D9.1 (K), D10.1 (K), D13.1 (K), D14.1 (K), D15.1 (K), D16.1 (K), D17.1 (K), D18.1 (K), D19.1 (K), D20.1 (K), D21.1 (K), D22.1 (K), D23.1 (K), D24.1 (K), D25.1 (K), D26.1 (K), D27.1 (K), D28.1 (K), D29.1 (K), D30.1 (K), D31.1 (K), D32.1 (K), D33.1 (K), D34.1 (K), D35.1 (K), D36.1 (K), D37.1 (K), D38.1 (K), D39.1 (K), D40.1 (K), D41.1 (K), D42.1 (K), D43.1 (K), D44.1 (K), D45.1 (K), D46.1 (K), D47.1 (K), D48.1 (K), D49.1 (K), D50.1 (K), D51.1 (K), D52.1 (K), D53.1 (K), D54.1 (K), D55.1 (K), D56.1 (K), D57.1 (K), D58.1 (K), D59.1 (K), D60.1 (K), D61.1 (K), D62.1 (K), D63.1 (K), D64.1 (K), D65.1 (K), D66.1 (K), D67.1 (K), D68.1 (K), D69.1 (K), D70.1 (K), D71.1 (K), D72.1 (K), D73.1 (K), D74.1 (K), D75.1 (K), D76.1 (K), D77.1 (K), D78.1 (K), D79.1 (K), D80.1 (K), D81.1 (K), D82.1 (K), D83.1 (K), D84.1 (K), D85.1 (K), D86.1 (K), D87.1 (K), D88.1 (K), D89.1 (K), D90.1 (K), D91.1 (K), D92.1 (K), D93.1 (K), D94.1 (K), D95.1 (K), D96.1 (K), D97.1 (K), D98.1 (K), D99.1 (K), D100.1 (K), D101.1 (K), D102.1 (K), D103.1 (K), D104.1 (K), D105.1 (K), D106.1 (K), D107.1 (K), D108.1 (K), D109.1 (K), D110.1 (K), D111.1 (K), D112.1 (K), D113.1 (K), D114.1 (K), D115.1 (K), D116.1 (K), D117.1 (K), D118.1 (K), D119.1 (K), D120.1 (K), D121.1 (K), D122.1 (K), D123.1 (K), D124.1 (K), D125.1 (K), D126.1 (K), D127.1 (K), D128.1 (K), D129.1 (K), D130.1 (K), D131.1 (K), D132.1 (K), D133.1 (K), D134.1 (K), D135.1 (K), D136.1 (K), D137.1 (K), D138.1 (K), D139.1 (K), D140.1 (K), D141.1 (K), D142.1 (K), D143.1 (K), D144.1 (K), D145.1 (K), D146.1 (K), D147.1 (K), D148.1 (K), D149.1 (K), D150.1 (K), D151.1 (K), D152.1 (K), J1.2 (GND), J1.3 (GND), J1.6 (GND), J1.7 (GND), J1.10 (GND), J1.11 (GND), J1.14 (GND), J1.15 (GND), J1.19 (GND), J1.20 (GND), J1.22 (GND), J1.28 (GND), J1.34 (GND), J1.37 (MD1), J1.39 (MD0), J1.40 (GND), J1.46 (GND), J1.52 (GND), J1.54 (GND), J1.97 (GND), J1.101 (GND), J1.105 (GND), J1.112 (GND), J1.116 (GND), J1.122 (GND), J1.144 (GND), J1.159 (GND), J1.162 (GND), J1.180 (GND), J1.181 (GND), J1.199 (GND), J1.S1 (SHIELD), J1.S2 (SHIELD__1), J4.20, J6.15, J6.16, J7.14, J7.16, J7.17, J7.18, J7.19, J7.20, J8.17, J8.18, J10.13, J10.15, J10.17, J10.18, J10.19, J10.20, J11.20, J13.A1 (GND), J13.A12 (GND), J13.B1 (GND), J13.B12 (GND), J13.S1 (SHIELD), R10.2, R11.1, R13.2, R14.2, R21.2, SW1.1, SW1.6, SW2.1, SW2.6, SW3.2, U1.7 (GND), U2.3 (GND), U3.10 (GND), U4.1 (GND), U4.5 (GND), U4.10 (AGND), U4.11 (GND), U4.13 (TEST), U4.15 (GND), U4.25 (GND), U4.35 (GND), U4.47 (GND), U4.51 (GND), U5.5 (GND), U6.2 (GND), U7.2 (GND), U8.4 (GND), X1.2, X1.4
unnamed: D1.2 (A), R1.2
unnamed: D2.2 (A), R2.2
unnamed: D3.2 (A), R3.2
unnamed: D4.2 (A), R4.2
unnamed: D5.2 (A), R5.2
unnamed: D6.2 (A), R6.2
unnamed: D7.2 (A), RN1.1 (R1.1)
unnamed: D8.2 (A), RN1.2 (R2.1)
unnamed: D9.2 (A), RN1.3 (R3.1)
unnamed: D10.2 (A), RN1.4 (R4.1)
unnamed: D13.2 (A), R8.2
unnamed: D14.2 (A), R9.2
unnamed: D15.2 (A), RN2.4 (R4.1)
unnamed: D16.2 (A), RN2.3 (R3.1)
unnamed: D17.2 (A), RN3.8 (R8.1)
unnamed: D18.2 (A), RN3.7 (R7.1)
unnamed: D19.2 (A), RN2.7 (R7.1)
unnamed: D20.2 (A), RN2.8 (R8.1)
unnamed: D21.2 (A), RN4.1 (R1.1)
unnamed: D22.2 (A), RN4.2 (R2.1)
unnamed: D23.2 (A), RN3.1 (R1.1)
unnamed: D24.2 (A), RN3.2 (R2.1)
unnamed: D25.2 (A), RN3.3 (R3.1)
unnamed: D26.2 (A), RN3.4 (R4.1)
unnamed: D27.2 (A), RN3.5 (R5.1)
unnamed: D28.2 (A), RN3.6 (R6.1)
unnamed: D29.2 (A), RN2.6 (R6.1)
unnamed: D30.2 (A), RN2.5 (R5.1)
unnamed: D31.2 (A), RN5.2 (R2.1)
unnamed: D32.2 (A), RN5.1 (R1.1)
unnamed: D33.2 (A), RN6.10 (R7.2)
unnamed: D34.2 (A), RN6.9 (R8.2)
unnamed: D35.2 (A), RN6.11 (R6.2)
unnamed: D36.2 (A), RN6.12 (R5.2)
unnamed: D37.2 (A), RN6.13 (R4.2)
unnamed: D38.2 (A), RN6.14 (R3.2)
unnamed: D39.2 (A), RN4.6 (R6.1)
unnamed: D40.2 (A), RN4.5 (R5.1)
unnamed: D41.2 (A), RN4.4 (R4.1)
unnamed: D42.2 (A), RN4.3 (R3.1)
unnamed: D43.2 (A), RN6.16 (R1.2)
unnamed: D44.2 (A), RN6.15 (R2.2)
unnamed: D45.2 (A), RN4.7 (R7.1)
unnamed: D46.2 (A), RN4.8 (R8.1)
unnamed: D47.2 (A), RN7.1 (R1.1)
unnamed: D48.2 (A), RN7.2 (R2.1)
unnamed: D49.2 (A), RN7.3 (R3.1)
unnamed: D50.2 (A), RN7.4 (R4.1)
unnamed: D51.2 (A), RN5.3 (R3.1)
unnamed: D52.2 (A), RN5.4 (R4.1)
unnamed: D53.2 (A), RN8.15 (R2.2)
unnamed: D54.2 (A), RN8.16 (R1.2)
unnamed: D55.2 (A), RN8.14 (R3.2)
unnamed: D56.2 (A), RN8.13 (R4.2)
unnamed: D57.2 (A), RN8.12 (R5.2)
unnamed: D58.2 (A), RN8.11 (R6.2)
unnamed: D59.2 (A), RN9.8 (R8.1)
unnamed: D60.2 (A), RN9.7 (R7.1)
unnamed: D61.2 (A), RN9.6 (R6.1)
unnamed: D62.2 (A), RN9.5 (R5.1)
unnamed: D63.2 (A), RN9.4 (R4.1)
unnamed: D64.2 (A), RN9.3 (R3.1)
unnamed: D65.2 (A), RN9.2 (R2.1)
unnamed: D66.2 (A), RN9.1 (R1.1)
unnamed: D67.2 (A), RN2.1 (R1.1)
unnamed: D68.2 (A), RN2.2 (R2.1)
unnamed: D69.2 (A), RN10.10 (R7.2)
unnamed: D70.2 (A), RN10.9 (R8.2)
unnamed: D71.2 (A), RN10.12 (R5.2)
unnamed: D72.2 (A), RN10.11 (R6.2)
unnamed: D73.2 (A), RN10.13 (R4.2)
unnamed: D74.2 (A), RN10.14 (R3.2)
unnamed: D75.2 (A), RN10.16 (R1.2)
unnamed: D76.2 (A), RN10.15 (R2.2)
unnamed: D77.2 (A), RN8.10 (R7.2)
unnamed: D78.2 (A), RN8.9 (R8.2)
unnamed: D79.2 (A), RN11.10 (R7.2)
unnamed: D80.2 (A), RN11.9 (R8.2)
unnamed: D81.2 (A), RN11.12 (R5.2)
unnamed: D82.2 (A), RN11.11 (R6.2)
unnamed: D83.2 (A), RN11.14 (R3.2)
unnamed: D84.2 (A), RN11.13 (R4.2)
unnamed: D85.2 (A), RN11.16 (R1.2)
unnamed: D86.2 (A), RN11.15 (R2.2)
unnamed: D87.2 (A), RN7.5 (R5.1)
unnamed: D88.2 (A), RN7.6 (R6.1)
unnamed: D89.2 (A), RN12.7 (R7.1)
unnamed: D90.2 (A), RN12.8 (R8.1)
unnamed: D91.2 (A), RN12.3 (R3.1)
unnamed: D92.2 (A), RN12.4 (R4.1)
unnamed: D93.2 (A), RN12.2 (R2.1)
unnamed: D94.2 (A), RN12.1 (R1.1)
unnamed: D95.2 (A), RN12.6 (R6.1)
unnamed: D96.2 (A), RN12.5 (R5.1)
unnamed: D97.2 (A), RN7.7 (R7.1)
unnamed: D98.2 (A), RN7.8 (R8.1)
unnamed: D99.2 (A), RN13.10 (R7.2)
unnamed: D100.2 (A), RN13.9 (R8.2)
unnamed: D101.2 (A), RN14.11 (R6.2)
unnamed: D102.2 (A), RN14.12 (R5.2)
unnamed: D103.2 (A), RN14.9 (R8.2)
unnamed: D104.2 (A), RN14.10 (R7.2)
unnamed: D105.2 (A), RN13.16 (R1.2)
unnamed: D106.2 (A), RN13.15 (R2.2)
unnamed: D107.2 (A), RN15.5 (R4.2)
unnamed: D108.2 (A), RN15.6 (R3.2)
unnamed: D109.2 (A), RN15.8 (R1.2)
unnamed: D110.2 (A), RN15.7 (R2.2)
unnamed: D111.2 (A), RN13.13 (R4.2)
unnamed: D112.2 (A), RN13.14 (R3.2)
unnamed: D113.2 (A), RN13.11 (R6.2)
unnamed: D114.2 (A), RN13.12 (R5.2)
unnamed: D115.2 (A), RN14.14 (R3.2)
unnamed: D116.2 (A), RN14.13 (R4.2)
unnamed: D117.2 (A), RN16.16 (R1.2)
unnamed: D118.2 (A), RN16.15 (R2.2)
unnamed: D119.2 (A), RN16.14 (R3.2)
unnamed: D120.2 (A), RN16.13 (R4.2)
unnamed: D121.2 (A), RN16.12 (R5.2)
unnamed: D122.2 (A), RN16.11 (R6.2)
unnamed: D123.2 (A), RN16.10 (R7.2)
unnamed: D124.2 (A), RN16.9 (R8.2)
unnamed: D125.2 (A), RN14.15 (R2.2)
unnamed: D126.2 (A), RN14.16 (R1.2)
unnamed: D127.2 (A), RN17.8 (R8.1)
unnamed: D128.2 (A), RN17.7 (R7.1)
unnamed: D129.2 (A), RN17.6 (R6.1)
unnamed: D130.2 (A), RN17.5 (R5.1)
unnamed: D131.2 (A), RN17.4 (R4.1)
unnamed: D132.2 (A), RN17.3 (R3.1)
unnamed: D133.2 (A), RN17.2 (R2.1)
unnamed: D134.2 (A), RN17.1 (R1.1)
unnamed: D135.2 (A), RN18.1 (R1.1)
unnamed: D136.2 (A), RN18.2 (R2.1)
unnamed: D137.2 (A), RN18.3 (R3.1)
unnamed: D138.2 (A), RN18.4 (R4.1)
unnamed: D139.2 (A), RN18.5 (R5.1)
unnamed: D140.2 (A), RN18.6 (R6.1)
unnamed: D141.2 (A), RN19.10 (R7.2)
unnamed: D142.2 (A), RN19.9 (R8.2)
unnamed: D143.2 (A), RN20.2 (R2.1)
unnamed: D144.2 (A), RN20.1 (R1.1)
unnamed: D145.2 (A), RN20.3 (R3.1)
unnamed: D146.2 (A), RN20.4 (R4.1)
unnamed: D147.2 (A), RN19.11 (R6.2)
unnamed: D148.2 (A), RN19.12 (R5.2)
unnamed: D149.2 (A), RN19.13 (R4.2)
unnamed: D150.2 (A), RN19.14 (R3.2)
unnamed: D151.2 (A), RN19.15 (R2.2)
unnamed: D152.2 (A), RN19.16 (R1.2)
unnamed: J1.35 (MD2), JP1.2 (B)
unnamed: J1.33 (MD3), JP2.2 (B)
unnamed: J13.A5 (CC1), R10.1
unnamed: J13.B5 (CC2), R11.2
unnamed: RN1.8 (R1.2), SW1.3
unnamed: RN1.7 (R2.2), SW1.4
unnamed: RN1.6 (R3.2), SW2.3
unnamed: RN1.5 (R4.2), SW2.4
unnamed: U1.3 (1Y), U1.5 (2B)
unnamed: U1.9 (3A), U2.4
unnamed: U1.10 (3B), U1.11 (4Y)
unnamed: U3.18 (B1), U4.16 (ADBUS0)
unnamed: U3.17 (B2), U4.17 (ADBUS1)
unnamed: U3.16 (B3), U4.18 (ADBUS2)
unnamed: U3.15 (B4), U4.19 (ADBUS3)
unnamed: U3.14 (B5), U4.21 (ADBUS4)
unnamed: U3.13 (B6), U4.22 (ADBUS5)
unnamed: U3.12 (B7), U4.23 (ADBUS6)
unnamed: U3.11 (B8), U4.24 (ADBUS7)
unnamed: U3.19 (~OE), U4.26 (ACBUS0)
unnamed: R13.1, U4.29 (ACBUS3)
unnamed: J13.A7 (D-), J13.B7 (D-), TP1.1, U4.7 (DM)
unnamed: J13.A6 (D+), J13.B6 (D+), TP2.1, U4.8 (DP)
unnamed: R16.2, U4.62 (EECLK), U5.2 (SCLK)
unnamed: R18.1, U4.61 (EEDATA), U5.3 (DI)
unnamed: C10.1, U4.2 (OSCI), X1.1
unnamed: C11.1, TP4.1, U4.3 (OSCO), X1.3
unnamed: R14.1, U4.6 (REF)
unnamed: C2.1, C4.1, FB2.2, U4.4 (VPHY)
unnamed: C1.1, C3.1, FB1.2, U4.9 (VPLL)
unnamed: R12.2, U4.14 (~RESET)
unnamed: R15.2, R18.2, U5.4 (DO)
unnamed: C16.1, U6.4 (NR)
unnamed: C19.1, U7.4 (NR)
unnamed: R20.2, R21.1, U8.3 (SENSE3)
unnamed: R19.2, SW3.1, U8.7 (~MR)
