swittlich/CcSoM/(commit log)

2026-09-17 Migrate project files to KiCad 10 format
    Re-saved all schematics, the PCB and the SOP-8 footprint with
    KiCad 10 (generator_version 9.0 -> 10.0). No components, nets,
    placements or values were changed - this only updates the file
    schema (new default fields, refreshed UUIDs) that KiCad 10 adds
    on save.
    [DCDC.kicad_sch, FPGA_IO_Config.kicad_sch, FPGA_Power.kicad_sch, FPGA_TOP.kicad_sch, Flash.kicad_sch, SODIM.kicad_sch, SOM.kicad_sch]
2026-09-17 Use custom BGA-324 footprint with embedded 3D model
    - Replace generic Package_BGA KiCad footprint with own
    ccsom_Footprint_lib:BGA-324_15x15mm_Layout18x18_P0.8mm,
    matching the actual GateMate BGA-324 pinout
    - Add Ironwood-BGA-324-Socket footprint to the library
    - Embed CCGM1A1_2.step directly in the footprint instead of
    referencing a separate 3D model file
    - Make fp-lib-table and sym-lib-table paths portable via
    ${KIPRJMOD} instead of a hardcoded local path
    [SOM.kicad_pcb]
2026-09-17 Ignore KiCad autosave, backup and lock files
2026-09-21 NetTie-Symbole und -Footprints ergaenzen
    Das DualCardTester-Baseboard verbindet die IO-Pins beider SoM-Karten ueber
    Net-Ties. Die zugehoerigen Symbole NetTie_1,08 und NetTie_1,524 sowie die
    Footprints NetTie-2_SMD_Pad0.108mm und NetTie-2_SMD_Pad0.15mm fehlten in der
    Bibliothek und kommen aus dem Projekt-Repository.
    Baseboards/SoMTester ist vorerst ignoriert, solange das Repository privat ist.
2026-09-22 Update Footprint from SoM Connector to use relative paths
2026-09-22 Footprint SoM Connector fix, too
    [SoMProgrammerNTester.kicad_pcb]
2026-09-23 Add Component SOP65P640X120 for UART com. to lib
2026-09-24 Fix GND pin type of ECS-5032MV oscillator symbol
    Pin 2 (GND) was bidirectional and clashed with PWR_FLAG in ERC.
    Set it to power input, matching VCC.
